MacAnalog/dn-005-pmu-ldo-capless-ihp130/doc/design-reference.md

# Design reference

KIND: REFERENCE (curated semantic facts; the pack carries the constraints section in full)

## Topology of record — `ldo_ihp_capless`

A **double-mirror flipped-voltage-follower (FVF)** output stage under a slow, high-gain outer
loop, in `sg13_lv_*` at 1.5 V. Chosen in experiment 002, sized in 003, drawn in 005.

**Read the schematic of record beside this section**, five blocks on one top sheet:
[`experiments/004-schematic/figs/ldo_ihp_capless.png`](../experiments/004-schematic/figs/ldo_ihp_capless.png),
regenerated by `experiments/004-schematic/build_sch.py` from the certified netlist and proven
equal to it device by device and parameter by parameter. The flat control sheet is
`ldo_ihp_capless_flat.png` beside it; the per-block sheets are `blocks_*.png`.

- **Output stage.** Pass PMOS `XMP` (19 fingers x 10 um, L 0.13 um). Control PMOS `XMC` whose
  source IS `vout` — the fast local loop. `XMC`'s drain current is folded to the pass gate as a
  **pull-up** through an NMOS 1:1 mirror (`XMA`/`XMB`) and then a PMOS 1:1 mirror (`XMCP`/`XMD`);
  the constant sink `XMS` pulls the gate down. The fold is what lets the gate reach `vdd - Vsd,sat`
  so the pass device turns fully **off** at hot/fast corners — a plain FVF caps the gate at `vout`
  and leaks 80-470 uA there (`journal/plain-fvf-gate-ceiling.md`). Each mirror node is a diode,
  i.e. low impedance, so the fold adds no high-impedance pole where a source-follower buffer did.
- **Outer loop.** Two-stage error amplifier: PMOS-input 5T OTA (`XMT`/`XM1`/`XM2`/`XM3`/`XM4`)
  then an NMOS common source under a PMOS current source (`XM5`/`XM6`), Miller cap `XCC` across
  stage 2 (dominant pole at `ea_o1`). It sets DC accuracy, PSRR and load/line regulation; the FVF
  sets the transient.
- **Feedback.** 1:1 `rhigh` divider `XR1`/`XR2` (340 um each) sensed through the 0 V loop-break
  marker `VLP`, with a 0.1 pF MIM `XCFF` across the top resistor cancelling the divider-node pole
  the resistors' own substrate capacitance makes.
- **Bias.** Resistor-referenced: `XRB` + NMOS diode `XMB0`, mirrored to the sink and, via the PMOS
  diode `XMBP`, to the error-amp tail. No ideal current sources. **This is the design's binding
  limitation** — see the constraint list below.
- **Output capacitor.** `XCOUT`, 4 x 5 pF MIM units on chip (21 pF total incl. the bench's 1 pF),
  well under the 100 pF bound: 002 showed the transient is loop-speed-limited, not charge-limited.

**Instance names above are role names; the certified netlist emits them segmented.** Since the
2026-09-05 recertification onto the drawn device set, `circuits/ldo_ihp_capless/pdk/ihp-sg13g2/netlist.spice`
carries `XR1_1..8`, `XR2_1..8`, `XRB_1..5`, `XMB0A`/`XMB0B`, `XM1A`/`XM1B`, `XM2A`/`XM2B`,
`XM3A`/`XM3B`, `XM4A`/`XM4B` and `XMSA`/`XMSB` — a grep for the bare `XR1` or `XMS` finds nothing.
`XMP` renders as `x_dut_xmp_m * x_dut_xmp_nf_mult` fingers of `x_dut_xmp_w / x_dut_xmp_nf_mult`.

**Where each artefact lives:**

| artefact | path |
|---|---|
| the design of record (sizing knobs and their defaults; a bare `ldo.dut.CANDIDATE` renders it) | `circuits/ldo_ihp_capless/pdk/ihp-sg13g2/sizing.yaml` |
| certified decks, sha-locked | `signoff/prelayout/decks/` with `SHA256SUMS` |
| schematic of record | `experiments/004-schematic/` |
| layout generator | `layout/gen_ldo.py` |

## Device map — the reference

The reference `ldo_005_buffered_ref` (analog-db, IHP binding). All MOS are `sg13_hv_*`
(3.3 V family).

| role | instances | what it does |
|---|---|---|
| reference buffer | `XMRA_*`, Miller `RRAZ`/`CRAC` | gains an ideal 0.8 V `VREF` up through `R1`/`R2` to 1.6 V |
| reference filter | `R_LPF`/`C_LPF` | RC filter on the buffered reference |
| error amplifier | `XMEA_*`, Miller `REAZ`/`CEAC` | drives the PMOS pass device |
| pass device | `XMP` (w×m) | PMOS |
| output bleeder | `R3` | bleeds the output |
| output capacitor | `C1` | on-die 10 pF |
| loop-break marker | `VLP lp_brk vout` (0 V) | what the `ac_loopgain` bench turns into a generator |

Sizing knobs and their defaults: `circuits/ldo_005_buffered_ref/pdk/ihp-sg13g2/sizing.yaml`; an
`ldo.dut.Design` is that circuit id + a dict of knob overrides.

## Validated model

**Loop-gain → load regulation.** ΔVout ≈ ΔIload·Rout_ol/(1+T0). The record measures
loop gain 49.95 dB (T0 = 314) and load regulation 0.028 mV over 0.1 → 10 mA, i.e. an effective
closed-loop output resistance of 2.8 mΩ and Rout_ol ≈ 0.88 Ω — the pass device's own 1/gm at
10 mA, as the relation predicts. The relation also holds across the corner table: load regulation
tracks 1/(1+T0) (0.017 mV at loop gain 52.6 dB, 0.056 mV at 45.9 dB).

**Pass-gate capacitance → undershoot.** From `journal/fvf-gate-cap-is-slew.md`, the pull-down
slew is I_B/C_gate. The layout adds 28.4 fF to a ~1 pF gate (+3 %) and S7 moves 104.8 → 113.9 mV
(+8.7 %) with recovery 0.125 → 0.150 µs (experiment 005 §1) — the predicted direction, and the
right order of magnitude given the FVF is pull-down-slew-limited on the falling edge only.

## Facts that constrain every candidate

1. **Cout is on chip: ≤ 100 pF total at the output node.** The reference's benches hang a 1 µF
   external capacitor on `vout`; a candidate may not. This moves the dominant pole inside the
   loop and is the whole difficulty of the capless class (provenance: `harness.yaml` goal;
   the reference's `analyses/*.yaml` bind `COUT: 1u`).
2. **Thin-oxide devices at 1.5 V.** `sg13_lv_*` are the 1.5 V family in the PDK registry
   (`_shared/pdk/ihp-sg13g2.yaml: supply.default: 1.5`); the reference is hv at 3.3 V, so
   none of its sizing carries over, only its structure and its benches.
3. **Quiescent current ≤ 50 µA is measured at no load** (`dc_op`, `i_supply`) — a bleeder or a
   minimum-load device counts against it.
4. **The bias binds at both ends, and S7 against bias current is a THRESHOLD, not a ramp.**
   *Every number in this item — the 25.6/61.9 µA spread, the `r_bias_l` sweep, the 41–50 µA window
   — was measured at the **36.28 µA** sizing point and has not been re-derived on the re-certified
   33.81 µA cell. The corner grid itself was re-run there (`experiments/007-post-layout-corners/`),
   and it no longer supports the "one mechanism, both ends" reading for S7 post-layout; the
   constraint the bias still owns at this sizing point is S5 at ff/125 °C.*
   The resistor-referenced bias makes every branch current scale with `rhigh`'s sheet resistance:
   Iq runs 25.6 µA at ss/−40 °C to 61.9 µA at ff/125 °C, a 2.4× spread on a 36.3 µA nominal. The
   resistor corner alone reproduces **both** failures; neither the transistor nor the capacitor
   corner reproduces either.

   **The S7 failure is a step.** Sweeping the bias resistor at ss/−40 °C:

   | Iq at ss / −40 °C (µA) | 30.9 | 28.8 | 27.8 |
   |---|---|---|---|
   | S7 (mV) | 83.8 | 88.3 | **309.8** |

   That is 3.5× of undershoot for a 3.4 % change of current, and the recovery time steps with it:
   0.14–0.20 µs below the threshold against 1.27–1.33 µs above it. It is a change of mechanism —
   the gate sink stops being able to slew the pass gate within the load step — not a degradation
   of one, and it is the same signature as the `c_ff_w` cliff. The same threshold exists at
   tt/27 °C between 30.7 and 25.9 µA.

   *FIGURE MISSING — S7 against bias-branch current at ss/−40 °C and ff/125 °C on one axis, with
   the 150 mV bound drawn and the 41–50 µA window shaded. The points exist only as review prose:
   `doc/reviews/review-002-capless-ldo.md` §3.4 carries 5 at ss/−40 °C and 7 at ff/125 °C, and M6
   in §2 carries the tt/27 °C pair (118.8 mV at 30.7 µA, 200.8 mV at 25.9 µA); M6's reproduction
   cell counts 18 points across three corners, 14 of them printed. `experiments/003-sizing/figs.py`
   is where the figure belongs, beside the same shape it already draws for `c_ff_w`
   (`cff_cliff.png`) — but the `r_bias_l` sweep must first be re-run into
   `experiments/003-sizing/out/` by a committed script: typing the review's numbers into
   `figs.py` would repeat the defect `cff_cliff.png` already has.*

   **Total Iq is a misleading proxy for it.** Slow transistors at −40 °C *lower* Iq by 15 % and
   *improve* S7 from 105 to 84 mV; it is the bias-branch current, not the total, that sets S7.

   **What the exit path actually costs.** A supply-independent bias does not relax both ends at
   once: pinned at the design's own 36.3 µA it still fails S7 at ff/125 °C (**165 mV**).

   | quantity | value |
   |---|---|
   | window that clears both corners | **Iq ≈ 41–50 µA** |
   | rise the 36.28 µA headline would have to take | 13–38 %, spending most of its S5 margin |

   A constant-*gm* / beta-multiplier reference is the wrong prescription in kind: it holds
   transconductance constant, while the quantity that sets the pass-gate slew is a current, and a
   beta-multiplier current still tracks the resistor and the mobility. **The corner-robust
   headline is therefore 41–50 µA, not 36.28 µA.**
   Provenance: `experiments/003-sizing/README.md` §3, `journal/resistor-bias-spread-binds-both-ends.md`,
   `doc/reviews/review-002-capless-ldo.md` §3.4 + M6 (18 bias points across three corners).
5. **Phase margin is measured with the true loop bench** (`ac_loopgain`, Middlebrook injection
   at `Vlp`), not the Zout-peaking proxy: the proxy read 0 dB on a revision of the reference
   that had no loop gain at all (analog-db `datasheet.yaml`, `pm_loop_deg` note).
