MacAnalog/dn-005-pmu-ldo-capless-ihp130/layout/ldo_ihp_capless/REVIEW.md

# Layout review — `ldo_ihp_capless` (IHP SG13G2), **round 4 re-review**, verdict **PASS with majors**

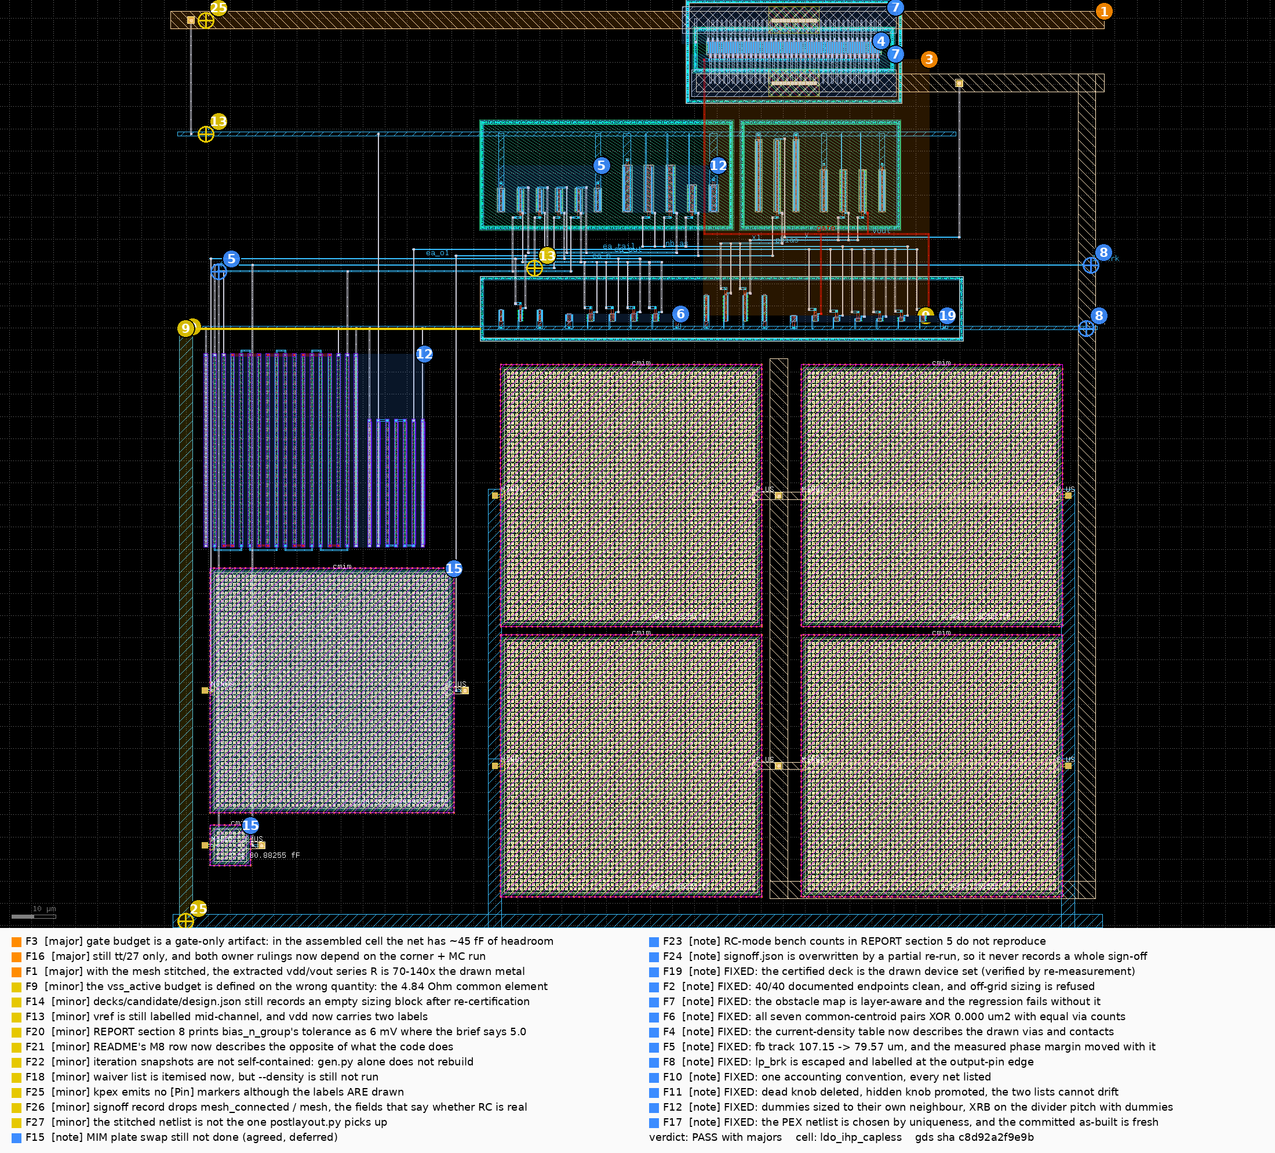
[picture p1: layout/ldo_ihp_capless/REVIEW.png]
annotated review


**KIND: REVIEW.** Independent gate on the fix round (`7ccc7b1`, layout of record **it12**), on top
of the re-certified deck (`bf3a4f8`) and the re-derived brief (`223373e`). Everything below is a
number this reviewer produced by rebuilding the GDS from the committed `layout/gen_ldo.py` and
re-running the tools; the designer's numbers are treated as claims throughout. Supersedes
`review-003` (FAIL, 3 blockers), whose nineteen findings are each given a verdict **by
measurement** at the end of the table.

**Verdict: PASS with majors.** The drawing reproduces completely — same GDS bytes, DRC 0, LVS
matched at both sizing points, 40/40 knob endpoints, current density 30/30, and all eighteen
post-layout metrics identical to the committed scorecard. **All three review-003 blockers are
closed**: the certified deck is now the drawn device set (F19, verified by re-measurement), the
knob ranges are walked and gated (F2, 40/40), and the undershoot credit is no longer banked (F3).
Three majors stay open, and none of them breaks a spec at tt/27:

1. **The `gate` budget is a gate-only artifact.** Everything the report measures reproduces, but
   nobody measured the net's headroom in the assembled cell. Swept in situ it is **~45 fF at
   0.44 mV/fF with no step** — the drawn 34.45 fF sits at about 43 % of what the net can carry.
   Owner ruling 1 asks for a topology decision on a number the assembled cell contradicts (F3).
   Demoted since the first draft of this review: **F9**, the `vss` active return. The report's
   14.3 Ω is wrong (mine: 20.88 Ω, 1.27× the brief's per-device budget), but I then put the solved
   return in circuit and the entire drawn per-device spread is worth **+0.04 dB** of PSRR. What the
   metric follows is the 4.84 Ω common element (−2.82 dB), which is 0.29× of budget. F9 is now a
   **minor**: a budget defined on the wrong quantity, and two wrong numbers in REPORT §6.4/§10.4.
2. **Still tt / 27 °C only**, and both owner rulings now depend on the corner + Monte-Carlo run
   that has never been done. The brief itself prices `ea_nmos_load` at 0.61 σ, which is **11 % of
   dies** on the dangerous sign of one class alone (F16).
3. **The RC extraction's mesh is now joined but its values are not usable.** On the fixed platform
   the port-to-device resistance of `vdd` is **49 Ω** where the drawn metal is 0.59 Ω, and nine of
   thirteen benches time out. The series-R numbers of record stay hand models — correct ones (F1).

## Findings

| # | severity | where (net / device / rule) | evidence | effect | fix → generator parameter | expected |
|---|---|---|---|---|---|---|
| **F3** | major | `gate`; pass array (47.57, 61.77)–(87.25, 64.89); Metal3 gate track (46.94, 3.01)–(98.09, 60.77) | Every reported number reproduces: `gate` 44.50 fF total / **34.45 to-rail** / 8.911 to `vout`; gate-only S7 **201.744 mV** (report 201.72); I built and extracted at `x_dut_xmp_nf_mult` = 2, 4, 8 and got to-rail **26.63 / 34.45 / 50.03 fF** — 3.91 and 3.895 fF per unit, intercept **18.81 fF** (report 3.9, ~18.8), and nf = 2 fails current density at **1.4626×** (report 1.46×). What nobody measured is the headroom **in the assembled cell**: sweeping a lumped `gate`→`vss` capacitor on the full 186-card extraction through the frozen `tran_load_step` gives S7 = 127.560 / 129.673 / 132.100 / 137.404 / 147.293 / 167.900 mV at +0 / 5 / 10 / 20 / 40 / 80 fF — **0.44 mV/fF, smooth, no step**, crossing 150 mV at **≈ +45 fF**. The brief's "step between 12 and 13 fF" is measured with every other parasitic zeroed; the assembled cell does not have it. | `v_undershoot_mv`: 22.4 mV of measured margin, and ~45 fF (130 % of the drawn value) of headroom on the very net the budget calls 2.87× over (what-if) | **new feature — a measurement, not a fix.** Run the full-PEX corner + MC sweep before an owner is asked to change the pass device, change the output stage, add a certified `ea_o1` capacitor or widen S7. A gate-only budget cannot answer whether 22.4 mV survives ss/−40. | ruling 1 either dissolves or acquires a number; today it has neither |
| **F16** | major | whole cell | Unchanged and now load-bearing. Both scorecards are tt / 27 °C. Three things make this the decisive gap: F3's margin is a cancellation whose corner behaviour is unmeasured; `brief.json` prices `ea_nmos_load` at 1.0 mV tolerated against a PDK 1 σ of **1.6468 mV** with `out_of_box` at 2.0 mV — I re-derived that σ myself, √2·A_VT/√(W·L) with A_VT = 2.0 mV·µm and W·L = 2.95 × 1.0 µm on the **whole** device, = 1.6468 ✓ — so **P(ΔVT > 2 mV on the dangerous XM3 side) = 11 %** of dies from one class alone, and `bias_p_group` is 9 %; and the re-certification moved Iq to 33.81 µA, toward the S7-vs-bias step review-002 M6 put near 30.7 µA. | not quantified — that is the finding | **new feature** — post-layout corner sweep on the extracted subckt plus a mismatch Monte Carlo on the drawn device set. | the input both open rulings are missing |
| **F1** | major | `vdd` strap (−73.5, 67.55)–(137.64, 71.55); `vout` riser (61.69, 52.33)–(73.13, 58.33); pass array; pins (−65.5, 69.55) and (133.64, 0.0) | Re-extracted on the fixed platform (`@b61f6c7`, `stitch_mesh=True`): **`mesh_connected=True`, 220 of 243 device pins on the mesh, 0 open nets**, 19 stub nets (the 18 divider nets + `lp_brk`, the rhigh terminal-region limit). The topology defect is fixed. The **values** are not usable here: solving the extractor's own network, R(`vdd` port → each of the 39 pass source columns) = **49.14–49.19 Ω**, identical for every column, i.e. a **~41 Ω common series element** on a path whose drawn TopMetal1 I solve at **0.59 Ω** and whose Metal2 comb at 0.017 Ω; R(pass drains → `vout` port) = **77.6 Ω** against 0.51 Ω drawn; column-to-column ≈ 16 Ω of terminal region in series with each 2.5 µm finger. The riser is 48 cuts per level plus 12 TopVia1, so 41 Ω implies ≈ 2 kΩ per cut — a figure **inferred from the arithmetic**, not read out of kpex. The benches agree: **9 of 13 fail** (was: singular matrix), and the log names the mode — ngspice drops from KLU to SPARSE 1.3, coerces all 33 `Rstitch_` to 1e-12 Ω, then `Dynamic gmin stepping failed` / `True gmin stepping failed` / `source stepping failed` / `Transient op started`: **the DC operating point does not converge**, and the transient-op fallback runs out the 600 s budget and the four that finish give psrr_1k **−5.549 dB** against 70.09. The one credible net is `vss`, because that path is Metal1 end to end — and there the mesh (4.11 Ω aggregate, 10.5–24.0 Ω per device) matches my drawn-metal solve (4.84, 12.5–20.9) to ~15 %, which is what makes F9 a two-method result. | `v_dropout_mv` **+10.8 mV**, 45 % of the brief's 23.83 mV pool (hand model, now *solved* on the drawn metal: 10.34 × 0.5895 + 8.64 × 0.5446; report 10.98 mV / 46 %) | **new feature, upstream.** Report the residual kpex defect with these numbers — it is terminal/via resistance, a different defect from the island just fixed. Add a sanity gate beside `mesh_connected` (port-to-pin R orders of magnitude above the drawn metal's bound ⇒ refuse). And see F27: the stitched file is not the one consumers glob. | RC becomes a measurement when the terminal values are fixed; until then the hand model stands |
| **F9** | minor | `vss` riser (−71.5, −135.5)–(−68.5, 0.3); bare rail run (−70.0, 0.0)→(−3.4, 0.0); `XMSb` (95.72, 1.42)–(97.35, 2.88) | **(a) The report's number is wrong.** §6.4 models the worst active device at **14.3 Ω** of a 16.4772 Ω budget ("89 % spent"). Solved instead of modelled — Metal1 rasterized at 0.1 µm, component flood-filled from the `vss` pin, Laplace at 110 mΩ/sq (validated on an analytic bar to −0.1 %): common series element **4.84 Ω** (report 4.91 ✓), worst device `XMS`b **20.88 Ω** = **1.27×** budget. Mechanism: from the riser top the return runs **66.6 µm of bare 0.8 µm rail** (9.44 Ω) before the row-A ptap ring begins — that ring spans only x = −3.4 to 105.58, and §6.4 credits it over the whole 170 µm. 14.3 Ω is my solve for a device at **x = 0**, the near end. §10.4's "`rail_w` 1.2 → ~12.7 Ω" has the same error; interpolating my two solved builds gives ~16.6 Ω, on the budget line. **(b) But that is not the quantity the metric follows.** Put in circuit through the frozen benches (every vss-connected element behind the common element, each active group behind its own extra hop, XCOUT on its own strap — the generator's split): common 4.84 Ω alone → psrr_1k **67.277 dB**; adding the full drawn 14.4–20.9 Ω spread → **67.316 dB**. The whole distributed per-device return is worth **+0.04 dB**. As a lumped element the drawn cell is ~4.9 Ω = **0.30× of budget**. Controls confirm the report's own partition: active devices alone behind 32 Ω move psrr_1k **+0.099 dB** and S7 +0.11 mV; XCOUT alone behind 32 Ω improves S7 to 114.0 mV. | `psrr_1k_db` **−2.82 dB** (what-if) — and this is the real content: the committed 70.093 dB is measured with the ground return **ideal** (CC carries no vss resistor; XCOUT is re-attached by name to the pin), so 2.82 dB of the reported figure is a modelling choice, 2.78 dB of it the common element. S6 is ≥ 40 dB, so 67.3 dB is not a spec risk. Caveat: this moves `VREF`'s return onto the internal ground with everything else — the frozen bench's own convention (VREF lives inside the DUT block), and the reason my −0.372 dB/Ω reproduces the brief's −0.4553, so it is the right model for checking the brief. | **Correct the brief, not the drawing.** Budget `vss_active` on the **common series element** (4.84 Ω drawn, 0.29×) and drop the "worst active device" row — I measured it at +0.04 dB. Correct §6.4 (14.3 → 20.88 Ω at the far end) and §10.4 (1.2 → ~16.6 Ω). Only if the corrected budget ever binds: `rail_w` = 1.4 is measured (bounds build, DRC 0, LVS matched, CD 0.836×) at 15.13 Ω worst / 4.84 Ω common, worth **+1.15 dB** in circuit; `vss_ret_w` = 6.0 takes the common element to 2.43 Ω and is the better lever for the quantity that matters. | no metric moves > ~1 dB of a 27 dB margin; the deliverable is a corrected budget row and two corrected REPORT numbers |
| **F25** | minor | pins (−65.5, 69.55), (133.64, 0.0), (−70.0, −134.0) | The kpex report database has **594 `[Device Terminal]` markers and zero `[Pin]` markers**, although the GDS carries 17 text labels **and those labels do reach kpex** — its raw netlist header is `.SUBCKT ldo_ihp_capless vss fb lp_brk ea_o1 ea_out nbias x1 y gate ea_n vdd ea_tail vref pbias vout`, 15 ports derived from them. So "the generator draws no pin labels" is not the mechanism; whatever makes a `[Pin]` marker, a text label on the routing layer is not it. So the stitcher has no port anchor and ties each flat net at a node it picks — `vdd.P0.25`, `vout.P0.25`, `vss.P0.24`: polygon 0 of a layer, not the pin. Every port-referred series-R number is therefore referred to an arbitrary point in the net. `vss` came out right only because its tie landed near the pin. | no electrical effect; it is why F1's numbers cannot be compared to a pin-referred budget | **Do not redraw anything yet.** A pin-datatype polygon per port (`vdd`/`vout` 126/2 + 126/25 at the strap ends, `vss` 8/2 + 8/25 at the riser foot, `vref`/`fb`/`lp_brk` likewise) is a **hypothesis** about what kpex 0.3.12 wants, not a diagnosis. Ask the platform which geometry produces a `[Pin]` marker — on the 5-T OTA example where the stitch was verified — then draw that. Same change F13 asks for from the other side. | the brief's series-R rows become directly checkable against the extractor |
| **F26** | minor | `layout/signoff.py` `pex()`, ~line 275 | `pex()` returns `{ok, available, mode, netlist, n_c, n_r, per_net_c_ff, reason, log_tail}` and drops `PexResult.mesh_connected` and `.mesh` — the two fields that separate "RC ran" from "RC measured something". On this cell they carry the real state: 220/243 pins, 0 open nets, **19 stub nets**, so any `fb`/`lp_brk` series-R statement from an RC run is empty. The stage prints `PEX: ok=True n_C=186 n_R=8566` and the JSON keeps no more. The docstring above the call is also stale — it explains a cwd dance to contain `<cell>_extracted.cir`, which the platform fixed at `97cc0be`. | no electrical effect; the record cannot distinguish a measured RC row from an empty one | **`layout/signoff.py`**: add `mesh_connected` and `mesh` to the dict, and gate on them the way DRC and LVS are gated now. | the round's JSON says how much of the mesh was connected |
| **F27** | minor | `layout/postlayout.py` `main()` | The platform writes `..._k25d_pex_netlist.spice` (raw) **and** `..._k25d_pex_netlist_stitched.spice`, and `PexResult.netlist_path` names the stitched one. `postlayout.py` selects with `rglob("*_pex_netlist.spice")` and demands exactly one match — the stitched name does not match that glob, so it finds exactly one file, reports no ambiguity, and measures the **raw** netlist. I had to symlink the stitched file under the expected name to run the benches on it. This is F17 in a new form, and worse: it fails silently and confidently. | an RC scorecard from this path would be the unstitched netlist, i.e. the artifact F1 says measures nothing (what-if) | **`layout/postlayout.py`**: take the path from the PEX stage's record (`signoff.json` already has `pex.netlist`), or prefer `*_stitched.spice`. | the file the extractor named is the file the benches measure |
| **F14** | minor | `decks/candidate/design.json` | Still `"sizing": {}`. The deck set was re-issued wholesale at `bf3a4f8` — all 13 `.spice`, `SHA256SUMS`, `decks.sha256`, `scorecard.json` — and the file named as the sizing of record is still empty, across a certification boundary that introduced a new knob (`x_dut_xmp_nf_mult`). | provenance only | write the resolved knobs at freeze time, or drop the key rather than carry it empty | the certified deck names its own sizing point |
| **F13** | minor | labels at (8.81, 13.53), (−62.6, 12.83), (−65.5, 43.83), (−65.5, 69.55) | PLAN A1 still says `vref` + `fb` on the **left** edge. `fb` moved and is at (−62.600, 12.830) — fixed. `vref` is at (8.810, 13.530), 71 µm inside the cell. New: `vdd` now carries **two** labels, Metal1 (8/25) at (−65.500, 43.830) and TopMetal1 (126/25) at (−65.500, 69.550) — the same ambiguity F9 raised for `vss`, now resolved there (exactly one `vss` label) and reintroduced here. | interface clarity; F25 shows why the pin location is not cosmetic | `gen_ldo` label placement — `vref` on the left edge, one `vdd` label — or amend A1 | one label per pin, on the declared edge |
| **F20** | minor | `bias_n_group` (66.54, 1.42)–(102.18, 2.88) | REPORT §8's columns are `tolerated \| 1 σ \| headroom`, and the `bias_n_group` row reads `6 mV dVT (step) \| 2.43 mV \| 2.06`. 6 / 2.43 = **2.47**, not 2.06. `brief.json` gives that class `tolerated.dvt_mv = 5.0`, `sigma 2.4318`, `headroom 2.056`, and BRIEF.md line 49 says "5 mV, 2.06 σ, step at 6 mV" — the printed value is the **step** in a column headed *tolerated*. Every other row closes (1.0/1.6468 = 0.607, 1.2/1.118 = 1.073, 2.9477/1.6197 = 1.820, 0.989/0.575 = 1.72, 20.78/1.6648 = 12.48, 40.59/1.6623 = 24.42). | none; the one row a reader would check is the one that does not close | generate §8 from `brief.json` (as the Iterations table is generated from `iterations.yaml`) with separate *tolerated* and *step* columns | every row's headroom = tolerated / 1 σ |
| **F21** | minor | `README.md` line 69 (M8 row) | Four claims, all now false: "**no case that fails without it**", "the power combs are **routed around** on Metal3 (`to_track_m3`) rather than claimed", "five cases", and a pointer to "REPORT §10.5" for an `xmp_nf_mult = 1` short. `claim_box` records the comb, `to_track_m3` is gone, `test_builder.py` has nine cases, REPORT §10 has no item 5, and `xmp_nf_mult` is no longer a layout knob. I ran the missing test: copy `router.py`, make `claim_box` a no-op, run the suite → **4 failures**, exit 1, including `test_without_the_claim_the_allocator_walks_into_the_comb: alloc returned 44.1, inside the comb`. | the row understates the repo | rewrite the M8 row; drop the dangling §10.5 reference | the closed-findings table matches the code |
| **F22** | minor | `iterations/it*/gen.py` | `it11/gen.py` is a full generator copy but lines 60–61 are `import netlist_ref as NR` and `from router import ObstacleMap`, resolved from the caller's path. Run as the trail implies it fails with `ModuleNotFoundError: No module named 'netlist_ref'`; it only builds with today's `layout/` on `PYTHONPATH`, i.e. against today's `router.py` — the file that changed in exactly the rounds the trail records. Harmless this time (it rebuilds byte-identical to `a66d15b5…`, which is how I verified the trail) but a snapshot that needs files outside itself is not a snapshot. | the trail's reproducibility is conditional on files it does not carry | `signoff.py _snapshot`: copy `netlist_ref.py` and `router.py` beside `gen.py` and record their shas | `python it<N>/gen.py` reproduces `gds_sha256` with nothing else on the path |
| **F18** | minor | whole cell | Half fixed: §3 now names all twelve waived rules, which is what the finding asked. But the run is still `--no_density`, so whether the waived set grew with a 4.8 %-larger floorplan and two new wide straps is unverified. My own DRC was `--no_density` too — I did not close this either. | DRC 0 is conditional on a rule set neither of us ran | run `--density` once and diff against the twelve | the waived set is measured, not assumed |
| **F15** | note | XCFF (−64.6, −121.5)–(−55.4, −112.3); XCC (−64.6, −109.5)–(−9.4, −54.3) | Accepted and deferred (§8.2 dev. 2, §10.9), worth ≈ +0.3° for a certified-netlist edit and a re-freeze. I agree with the disposition. `bf3a4f8` was the cheap moment — the netlist was being re-issued and re-frozen anyway — and it was not taken. | `pm_loop_deg` +0.3° (hand) | fold into the next re-freeze | a few fF off `fb` at zero simulated cost |
| **F23** | note | REPORT §5 | §5 states "RC: 8/13 ran, 7 violations" and that "the transient benches that do run reproduce the CC row exactly". On the same platform I get **4/13 ran, 4 violations**, with both transients — the two named — aborting, and the DC rows returning i_q 40.67 µA against 33.81 and line_reg 8.502 mV against 0.056. R counts differ too (8545 `Rext_` vs 8548). The conclusion is unaffected and independently proved by the node sets; the counts are artefacts of an ill-conditioned matrix and should not be quoted as measurements. | none | state the node-set test, drop the bench counts | one deterministic statement instead of two run-dependent ones |
| **F24** | note | `layout/signoff.py` `main()` | `rec` is built from this invocation's stages and written whole, so the documented two-step PEX flow leaves `signoff.json` containing only `{"pex": {...RC...}}`. I hit it: after my RC pass the file had lost the build, current-density, DRC and LVS verdicts I had just produced. They survive only in the console log, which is not the artifact. | none | merge into an existing `signoff.json`, or write one file per invocation | one file carries every stage of the round |
| **F19** | note ✅ **fixed** | `bias_n_group`; pass array | Ruling adopted (PLAN §0.1, `bf3a4f8`). In the file: the certified netlist carries `XMB0A/B`, `XMB1A/B`, `XMSA/B`, `XM1A/B`…`XM4A/B` as half-width cards, `XR1_1..8`, `XR2_1..8`, `XRB_1..5` as segment strings, and `XMP … w={x_dut_xmp_w/x_dut_xmp_nf_mult} m={x_dut_xmp_m*x_dut_xmp_nf_mult}`. By measurement: my extraction with all 186 `Cext_` deleted returns i_q **33.80539**, v_out **1.199499**, undershoot 115.065, pm 72.5064, dropout 104.671 — `decks/candidate/scorecard.json` to the resolution of every bench. | — | — | closed |
| **F2** | note ✅ **fixed** | `LayoutParams.BOUNDS` | I re-ran the new `bounds` stage: **40/40 built, DRC 0, LVS matched, current density pass**, worst 0.9835×. DRC and LVS are gates now (a non-matching build writes no scorecard). `tap_pitch` deleted, `isl_gap`/`gpad`/`vss_ret_w` promoted, and an assert forces `set(BOUNDS) == LayoutParams` fields. The `xmp_nf_mult` half moved to `sizing.yaml` and is handled there: building at the off-grid `= 3` now raises *"XMP: unit finger 3.33333 um is not a multiple of 0.01 um"* instead of silently drawing a 189.81 µm device. Residue, not a finding: nothing walks the **sizing** space, and `= 8` is legal (DRC 0, LVS matched, CD 0.836× in my own build) at 50.03 fF of `gate` — see F3 for why that is now a smaller worry. | — | — | closed |
| **F7** | note ✅ **fixed** | Metal2 combs (42.18, 64.33)–(90.54, 72.55) and (44.28, 52.33)–(90.54, 61.93) | `claim_box` records any drawn rectangle on a named layer and `column_free` compares per layer, so the combs are obstacles to Metal2 and invisible to Metal3 — which let the hard-coded `to_track_m3` go. I ran the "fails without it" test: `claim_box` as a no-op fails **4 of 9** cases, exit 1, including `test_without_the_claim_the_allocator_walks_into_the_comb`. And the class is gone: `col_vias` 3 and 4, which extracted `gate\|vout` before, both LVS-match in the walk. | — | — | closed |
| **F6** | note ✅ **fixed** | `ea_in_pair` (0.29, 26.16)–(23.99, 36.78); `ea_nmos_load` (15.74, 1.42)–(41.82, 3.255) | My own test on this drawing: at device bbox + 1.2 µm all **seven** pairs read **0.000 µm²** with equal Via1 counts (3v3, 3v3, 1v1, 1v1, 1v1, 2v2, 1v1) — better than the report's 0.000–0.011. At my wider +2.4 µm window the two row-A groups stay 0.000 while `ea_in_pair` reads 42.2 % / 12.3 %; since +1.2 is exactly zero, all of it lies in the 1.2–2.4 µm annulus, i.e. the neighbourhood, as the report says. `ea_in_pair` now sits at the row end (F5) so its halves see different outer neighbours — a second-order LOD term at 1.82 σ; the 0.61 σ class is symmetric at both windows. | — | — | closed |
| **F4** | note ✅ **fixed** | pass array (47.57, 61.77)–(87.25, 64.89) | `power_path.json` declares `n_vias = 2` on the S/D column Via1 and `7` on the diffusion contacts, over 30 segments. Counted from my rebuilt GDS: source side 40 Via1 columns / 79 cuts, drain side 39 / 77 — 2 per column except the single leftmost end column each side (x = 45.18, 47.13), which serves one finger. Contact histogram is dominated by 73 columns of 7. Both declared numbers are the drawn ones, and the table now also carries the rails and both `vss` returns. CD 30/30, worst 0.836×, reproduced. | — | — | closed |
| **F5** | note ✅ **fixed** | `ea_in_pair` moved to the head of row B; `fb` label (−62.6, 12.83) | Device boxes now at x = 4.67 / 9.05 / 13.43 / 17.81 with `bias_p_group` to their right. Measured in my extraction: `fb` 33.97 → **31.90 fF total / 21.20 to-rail**, **0.78×** of the 27.1 fF budget. Phase margin 68.76 → **69.301°** in the reproduced row. | `pm_loop_deg` +0.54° (what-if) | — | closed |
| **F8** | note ✅ **fixed** | `lp_brk` label (134.64, 14.23) beside the `vout` pin (133.64, 0.0) | The GDS now says where the divider senses: `lp_brk` escaped and labelled at the output-pin edge, recorded as an interface contract in PLAN A12, with the choice settled by measurement (sensing at the pass drain gives S2 = 10.22 mV against a 5 mV line). Cost reproduced: `lp_brk` 18.2 → 37.93 fF / 24.26 to-rail on a net with no budget. | — | — | closed |
| **F10** | note ✅ **fixed** | REPORT §7 | One stated convention (budgets are to-rail), every net listed, `x1` and `y` printed as values (11.38 / 6.91 and 11.62 / 8.34) instead of a bound, `fb` at 0.78×. Every entry reproduces to the digit against my own parse, including `Cext_127 fb↔lp_brk 4.2346 fF`. | — | — | closed |
| **F11** | note ✅ **fixed** | `LayoutParams` / `BOUNDS` | `tap_pitch` gone, `isl_gap` + `gpad` + `vss_ret_w` in both lists, and an import-time assert that the two sets are equal. 20 knobs; I walked all 40 endpoints. | — | — | closed |
| **F12** | note ✅ **fixed** | `bias_p_group` (28.57, 26.16)–(50.39, 36.78); resistor block (−66.0, −49.5)–(−16.1, −5.78) | Read from my rebuild: `bias_p_group` runs d(10.62) XMBP(10.62) XMT(10.62) XM6(6.15) d(6.15) — the right dummy matches its neighbour. The resistor block is one pitch throughout: divider 18 segments at 2.0 µm from −66 to −32 (16 members + a tied dummy each end) and `XRB` 7 segments at the **same** 2.0 µm from −29 to −17 (5 + a dummy each end), where it was 5 at 1.6 µm with none. | — | — | closed |
| **F17** | note ✅ **fixed** (see F27) | `layout/postlayout.py` | `hits[-1]` is replaced by "exactly one match, or list them with mtimes and stop", and the freshness half checks out by measurement: the committed `asbuilt/core_pex.sp` is byte-identical to my own extraction on all 186 `Cext_` cards. The file also grew `--keep-c` / `--drop-c` / `--no-c` and refuses to overwrite the record — which is how F3 and F19 above are reproducible by anyone. The *identity* half is re-opened as F27. | — | — | closed |

## Would a senior analog layout engineer accept this at a glance?

Graded on geometry read out of the GDS I rebuilt, not on impression.

| what a reviewer looks at | measured | verdict |
|---|---|---|
| matching sequence, `ea_in_pair` | generator declares XM1A·XM2A·XM2B·XM1B; the six slots at x = 0.29 … 22.19 are one pitch with a dummy each end, so the drawn sequence is d·**ABBA**·d with **both centroids at x = 12.14** | ✅ common centroid, which is what a *ratio*-setting pair needs |
| matching sequence, `ea_nmos_load` | declared XM3A·XM4A·XM4B·XM3B; six slots at x = 15.74 … 40.14, d·**ABBA**·d, **both centroids at x = 28.78** | ✅ |
| matching sequence, `bias_n_group` | declared XMSA·XMB1A·XMB0A·XMB0B·XMB1B·XMSB — and the drawn device heights read it back without trusting the source: 1.46 · **1.46 / 1.055 / 0.860 / 0.860 / 1.055 / 1.46** · 1.46 µm, mirror-symmetric, so d·**ABC·CBA**·d with **all three centroids at x = 84.36** | ✅ three-class common centroid, dummies both ends |
| matching sequence, `fvf_fold_n` / `fvf_fold_p` | four slots at x = 47.02 … 60.16: d·A·B·d, adjacent and same orientation, **not** a centroid — the generator's declared `same_row_same_orientation` | ✅ and it *exceeds* the brief, which asks only for `any` on `fvf_fold_n` (24.4 σ of headroom) and `same_row_same_orientation` on `fvf_fold_p` (12.5 σ) |
| technique used vs. technique the brief implies | brief: `common_centroid+dummies` on `ea_nmos_load`, `bias_p_group`, `ea_in_pair`, `bias_n_group`, the divider; `interdigitated+dummies` on the two MIM ratios; `same_row_same_orientation` / `any` on the folds. Drawn: centroid where a ratio is set, same-row for the 1:1 folds, one pitch + dummies on the divider — **every class matches or exceeds its declared pattern** | ✅ |
| dummy sizing, `bias_p_group` | d(10.62) · XMBP(10.62) · XMT(10.62) · XM6(6.15) · d(6.15) — read off the drawn heights; each end dummy is sized to **its own** neighbour, not to a common value | ✅ |
| pair geometry + neighbourhood | translation-XOR of all **seven** classes at device bbox + 1.2 µm = **0.000 µm²** each, with equal Via1 counts. This proves *geometry*, not sequence — at a ~4.85 µm pitch and a ~1.7 µm device the +1.2 µm window stops short of the neighbour, so the sequence rows above rest on the slot read, not on this | ✅ |
| do the tap rings **close**? | five well/substrate islands, each tap region merges to **one polygon with a hole** — a true ring, not contacts on a pitch: NWell islands (−3.71, 22.01)/(55.17, 22.01)/(44.57, 57.52) with 444 / 326 / 296 contacts and 0.98–0.99 bbox coverage, and two ptap rings (−3.40, −2.90) and (43.07, 50.83) | ✅ |
| resistors on one unit pitch | divider 18 segments at **2.0 µm** (16 members + a tied dummy each end); `XRB` 7 at the **same** 2.0 µm (5 + a dummy each end) | ✅ |
| capacitors on one pitch, dummy ring | XCOUT 2×2 on one pitch about a central top-plate spine, bottom plates on one side — but **no MIM dummy ring** | ⚠️ declared deviation (PLAN §6: a ring of 58 µm units would triple the block). Accepted, recorded |
| pin labels on the declared sides | `vss` ×1 ✅, `lp_brk` at the output edge ✅, `fb` on the left edge ✅ — but `vdd` carries **two** labels and `vref` sits **71 µm inside** the cell | ⚠️ F13 |
| strap width vs J_max | 30/30 current-density budgets, worst **0.836×**; over the 40-endpoint knob walk, worst 0.9835× | ✅ |
| **overall** | reads as a laid-out cell: framed rows, dummies sized to their neighbours, closed rings, one pitch per array, and common centroids that actually coincide to the nanometre | **ACCEPT**, with the two ⚠️ above |

## What reproduced

| | designer's claim | my measurement | |
|---|---|---|---|
| build | it12, area 44 266 µm² | GDS sha256 `c8d92a2f…` = `iterations.yaml` it12; area 44 266; bbox (−73.50, −135.50)–(137.64, 74.15) | **match** |
| trail | it11 → it12 moves 858.3 µm² on Metal1 | rebuilt `it11/gen.py` → `a66d15b5…` (its recorded sha); XOR against it12 = **858.26 µm² on layer 8/0 and zero on every other layer** | **match** |
| current density | 30/30, worst 0.836× | 30/30, worst 0.836×; `n_vias`/contacts verified against the drawn cuts (F4) | **match** |
| DRC | 0 | 0 (`--no_density`) | **match** |
| LVS | matched, against the re-certified netlist | matched; reference sha `f573b653…` from `netlist.spice` `f5c4efb0…`; card-by-card audit of the split | **match** |
| second sizing point | (PLAN gate 4) | 002 hand point (`76eddd6`, 13 knobs differ): build 41 055 µm², CD 0.836×, DRC 0, **LVS matched** | **match** |
| knob ranges | 40/40 endpoints clean | 40/40 built, DRC 0, LVS matched, CD pass; worst 0.9835× | **match** |
| PEX CC | 186 C / 21 R | 186 C / 21 R; every per-net number to the digit; `asbuilt/core_pex.sp` byte-identical | **match** |
| scorecard | 18/18, 0 violations | all 18 identical to the committed digits through the frozen path | **match** |
| F19 closure | certified deck = drawn devices | extraction with all 186 `Cext_` deleted = `decks/candidate/scorecard.json` at every bench's resolution | **match** |
| gate-only S7 | 201.72 mV | **201.744 mV** | match |
| `gate` vs `nf_mult` | 26.63 / 34.45 fF, 1.46× CD at nf = 2 | 26.63 / 34.45 / **50.03** at nf = 2 / 4 / 8; CD **1.4626×** at nf = 2; nf = 3 refused by an assert | match, extended |
| series R, TopMetal1 | 0.598 Ω (`vdd`), 0.556 Ω (`vout`) | Laplace on the drawn metal: **0.5895** and **0.5106** Ω; Metal2 combs add 0.017 / 0.034 Ω; pool 10.80 mV of 23.83 (45 %) vs the report's 10.98 / 46 % | **match** |
| series R, `vss` common | 4.91 Ω | **4.84 Ω** (drawn-metal solve), 4.11 Ω aggregate from the stitched mesh | match |
| series R, `vss` worst device | 14.3 Ω, "89 % of 16 Ω" | **20.88 Ω** drawn-metal, 10.5–24.0 Ω extracted — 1.27× the budget, but worth **+0.04 dB** in circuit | **DIFFERS — F9** |
| PSRR with the drawn ground return | not measured (return is ideal in both rows) | 70.093 → **67.316 dB** with the solved return in circuit; 67.277 dB from the common element alone | **new — F9** |
| RC benches | 8/13 ran, 7 violations | 4/13 ran, 4 violations (unstitched); **4/13 ran, 9 timeouts** (stitched) | **DIFFERS — F23, F1** |
| RC mesh | electrically absent | confirmed absent on the old platform; on `@b61f6c7` `mesh_connected=True`, 220/243 pins, 0 open nets, 19 stub nets — but 49 Ω port-to-device on `vdd` (F1) | fixed topology, unusable values |

## What I could not check

- **Corners and Monte Carlo** — still nothing outside tt / 27 °C, by either of us (F16). This is the
  largest open item in the cell, not a footnote.
- **DRC with `--density`** — not run by the designer and not by me (F18).
- **Wire resistance as an extracted quantity** — the mesh is joined now but its `vdd`/`vout` values
  are not credible (F1), so every series-R number here is a Laplace solve on the drawn metal at
  the PDK's own sheet resistances: an independent model, not an extraction.
- **The `vss` solve is Metal1-only.** I checked that net for Metal2 shunts and found none that
  matter (five 0.38 µm columns with one Via1 each and four 1.3 µm MIM-return pads). Substrate
  conduction is modelled by nobody.
- **MIM top-plate coupling and n-well-to-substrate junction capacitance** — in neither the
  extractor nor the model cards.
- **The sizing space is not walked.** I probed `x_dut_xmp_nf_mult` at 2, 3 and 8 only.
- **Mismatch Monte Carlo on the drawn cell** — not run. I checked the brief's σ arithmetic (right,
  and computed on the whole device) but did not simulate the distribution.
- **Iteration diffs** — I verified it11 → it12 by rebuilding and XORing. The other ten
  `diff_it*_it*.png` were not opened.
- **The report's "a Metal3-over-Metal2 shield costs only +3 fF on `gate`→`vout`" claim** — not
  rebuilt. ~51 µm² of added M3-over-M4 overlap at ~0.05 fF/µm² makes +3 fF plausible, and it is
  moot either way: F3 measures ~45 fF of in-situ headroom on that net.
- **Inductance, sealring, fill, ESD, antenna** — out of scope per PLAN §7.

## Verdict

**PASS with majors.** Nothing in the spec box is broken at tt / 27 °C, every gate reproduces, and
all three review-003 blockers are closed by measurement rather than by changelog. Three things
would go back to the designer and one to the platform:

1. **F3** — the `gate` budget is gate-only; swept in situ the net has ~45 fF of headroom at
   0.44 mV/fF with no step, so owner ruling 1 should ask for the corner run (**F16**), not for a
   topology change.
2. **F16** — the cell has never been measured outside tt / 27 °C, and the brief's own 0.61 σ on
   `ea_nmos_load` is 11 % of dies on the dangerous side. Both owner rulings depend on this run.
3. **F1** — the RC mesh is joined but reads 49 Ω where the drawn metal is 0.59 Ω, and nine of
   thirteen benches time out; the residual defect is terminal/via resistance and belongs upstream.

Every magnitude above is labelled `what-if` (measured on a modified netlist through the frozen
benches), `solve` (a Laplace or nodal solve on drawn geometry / extracted values) or `hand`
(arithmetic from PDK constants). F9 is the case for doing that: read as a hand model it was a
major, and one what-if through the frozen benches made it a minor. The `what-if` numbers are single-variable and can be A/B'd one at
a time.
