MacAnalog/dn-005-pmu-ldo-capless-ihp130/signoff/README.md

# Sign-off — the design of record

KIND: REFERENCE (what a reader is entitled to trust. `experiments/` is where these numbers came
from; this tree is what survived.)

**One rule decides whether a file belongs here: has it been measured, and does it say under what.**
An artefact reaches this tree when a bench produced it and someone wrote down the conditions.
Everything still being explored stays in `experiments/NNN-*/`.

## What is signed off

Fill one row per fidelity you have actually run. `status` is `certified` only when a signed ledger
row exists for it (`make certify ARGS="--author X --verified-by Y"`); anything else is `measured`,
`in progress` or `planned`.

| fidelity | what the number includes | scorecard | status | signed by | date |
|---|---|---|---|---|---|
| `prelayout` | schematic netlist; no interconnect parasitics | `prelayout/decks/scorecard.json` | certified | see its provenance block | 2026-09 |
| `postlayout-pex` | + R/C extracted from the layout of record | `postlayout-pex/decks/scorecard.json` | planned | — | — |
| `postlayout-em` | + EM-solved interconnect and passives | `postlayout-em/decks/scorecard.json` | planned | — | — |

A design that never draws a layout keeps only the first row and deletes the other two directories.

## The tree

| path | holds | written by |
|---|---|---|
| `schematic/` | the topology of record: the as-built subckt netlist, its xschem sheet, the sizing table | `schematic-of-record` skill |
| `layout/` | the layout of record: GDS, render, DRC and LVS reports | `layout/signoff.py` (the generator is code, and stays in `layout/`) |
| `<fidelity>/decks/` | the frozen bench decks, sha-locked by `make freeze` | `make certify` |
| `<fidelity>/decks/scorecard.json` | every spec key, its measured value and its verdict — written INSIDE the frozen dir, because that is where `--certify` writes it | `make certify` |
| `<fidelity>/figs/` | the figures that carry the claims, each regenerated by a committed script | `plot.py` / the fidelity's own script |
| `<fidelity>/tables/` | the same numbers as CSV, so a later run can diff them | `make certify`, experiment close-out |
| `<fidelity>/REPORT.md` | what was measured, under what conditions, and what it means | the person or agent closing that fidelity |

## Adding a fidelity

The three shipped directories are simulation fidelities of an electrical design. A design in
another physics domain adds its own directory beside them — TCAD drift-diffusion for a device
cross-section, 3-D FDTD for an optical structure — with the same contents (`decks/`, holding its
`scorecard.json`; `figs/`; `tables/`; `REPORT.md`) and a row in the table above.

**Two things make a new fidelity real rather than a folder:** a `REPORT.md` that states the solver
and its version, and a `scorecard.json` written by the same `metrics` code path as every other
fidelity. A number produced by a one-off script is a report, not a reference.

## What does NOT belong here

**A yardstick is not a sign-off.** A design often carries a second certified deck set — prior art,
a paper being replicated, the incumbent being beaten. It is frozen, it is sha-locked, it is
reproduced by `make check`, and it is still not this design's result. It stays in `decks/`.

The distinction is worth stating because the config key does not make it: `reference_scorecard`
means *the scorecard `make check` reproduces*, which a design may legitimately point at the
yardstick rather than at itself. So the key cannot tell you which directory is the design of
record — only the design's own docs can.

| directory | holds | goes in `signoff/`? |
|---|---|---|
| this design's certified benches | what this design achieved | **yes** — `signoff/<fidelity>/decks/` |
| the prior-art / replication baseline | what it is measured against | no — `decks/`, still frozen |

If both exist, say which is which in the table above, and give the yardstick a row in the design's
`doc/target-spec.md` instead.

## Wiring it to the harness

Three lines in `harness.yaml` point the machinery at this tree. Nothing else needs to change:

```yaml
frozen: [signoff/prelayout/decks]                       # sha-locked by `make freeze`
reference_scorecard: signoff/prelayout/decks/scorecard.json   # what `make check` reproduces
```

**A design that certified before 2.00 should NOT `git mv` its frozen directory here.** A certified
`scorecard.json` carries a provenance block naming its own artefacts by path, so moving the
directory invalidates the certification — `scorecard-recompute` goes red with *"raw
`<old-path>/decks.sha256` is missing"*, and regenerating it means a live re-certification and a
second actor's signature.

Point this tree at the directory instead: name it in the table above and in the fidelity's
`REPORT.md`. Move it physically the next time you re-certify anyway — the new provenance is then
written at the new path at no extra cost. **A sign-off tree that says where the design of record
lives is worth more than one that holds a copy nobody can verify.**

`make check` compares today's simulation against `reference_scorecard`, so it follows whichever
fidelity that line names. Promoting post-layout to the reference is a deliberate act: change the
line, re-certify, and say so in this README's table.

## The two frozen deck sets

| directory | what it is |
|---|---|
| `signoff/prelayout/decks/` | **this design's own** 13 certified benches — the design of record, pre-layout fidelity (was `decks/candidate/`) |
| `decks/reference/` | the analog-db **yardstick** `ldo_005_buffered_ref` — the prior art this design is measured against. Frozen and reproduced by `make check`, and not a result of ours; it is itself outside the box on four specs |

The design of record moved here under template 2.02; the yardstick deliberately did not, because
`signoff/` is for this design's results. The move carried the scorecard's `provenance.raw` pointer
with it — the sha is of the file's *contents*, which did not change, so every hash still
re-derives and `scorecard-recompute` is clean.

**Do not read `reference_scorecard` as naming the design of record.** It still points at
`decks/reference`, so **`make check` proves the yardstick reproduces, not this design's own
scorecard.** That is a real gap: nothing drift-checks the design of record. Decide it before the
next certification.

## One known local lint failure, and why it is not a defect

In a checkout that ran the certification, `make lint` reports:

```
[scorecard-recompute] ledger row 2026-09-07T23:02:35 'candidate_certify':
    raw decks/candidate/decks.sha256 is missing
```

**That row is correct and must not be edited.** It records where the file was when that run
happened; *"never hand-edit the ledger — an edited row is not evidence of a run"*. The scorecard's
own pointer moved with the directory and re-derives cleanly; only this historical row still names
the old path.

- `runs/` is git-ignored and per checkout, so **a fresh clone never sees this.**
- It clears at the next certification, which logs a row at the new path.
