MacAnalog/dn-005-pmu-ldo-capless-ihp130/layout/ldo_ihp_capless/iterations/diff_it01_it02.png

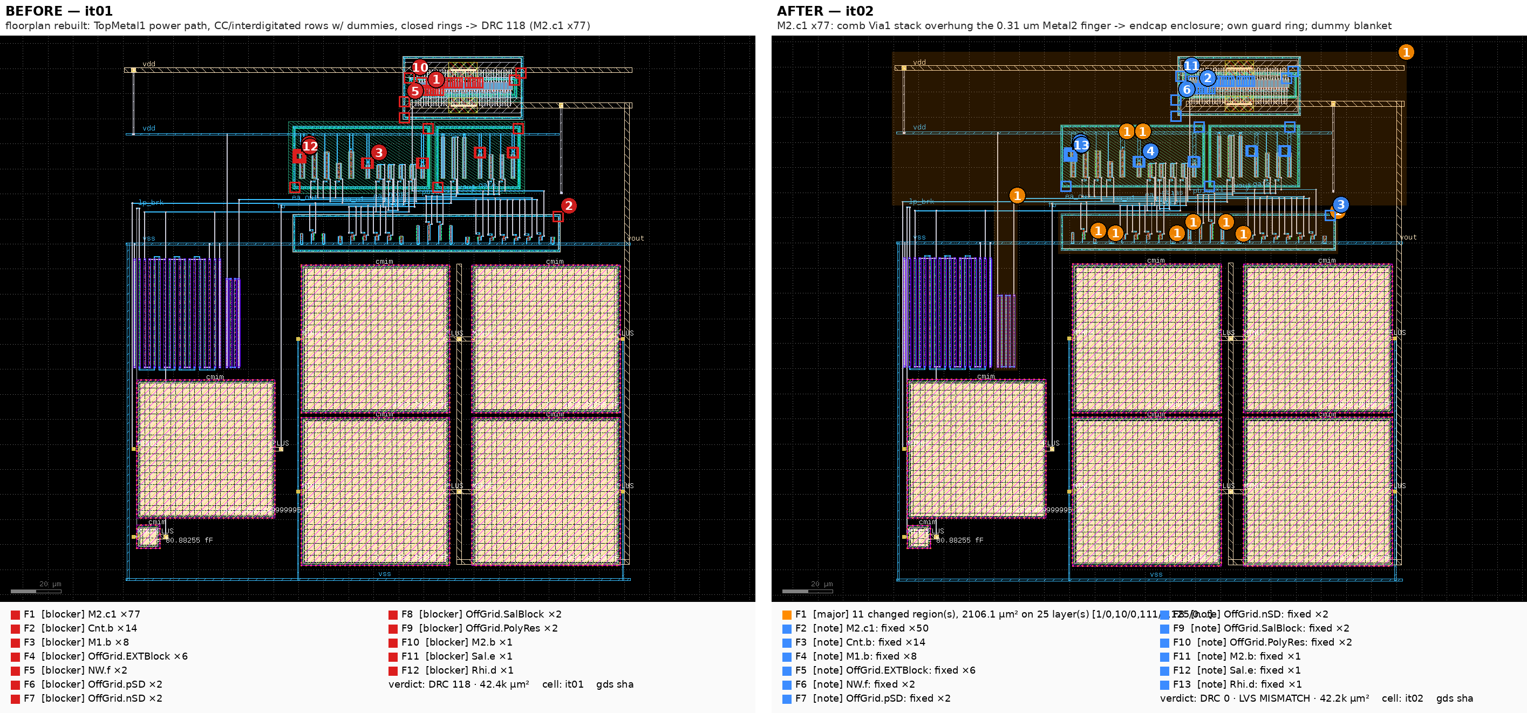
layout/ldo_ihp_capless/iterations/diff_it01_it02.png
