MacAnalog/dn-005-pmu-ldo-capless-ihp130/layout/ldo_ihp_capless/iterations/diff_it02_it03.png

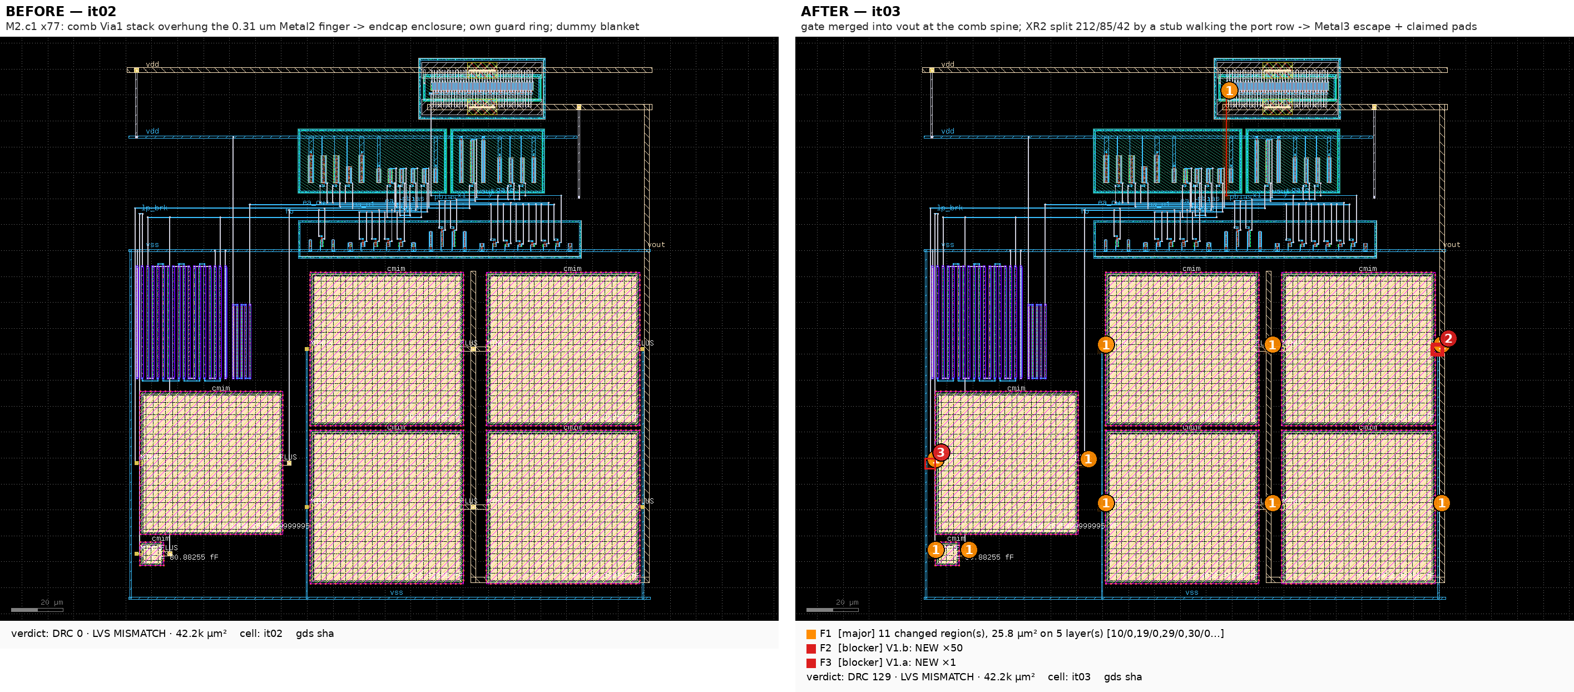
layout/ldo_ihp_capless/iterations/diff_it02_it03.png
