MacAnalog/dn-005-pmu-ldo-capless-ihp130/layout/ldo_ihp_capless/iterations/diff_it07_it08.png

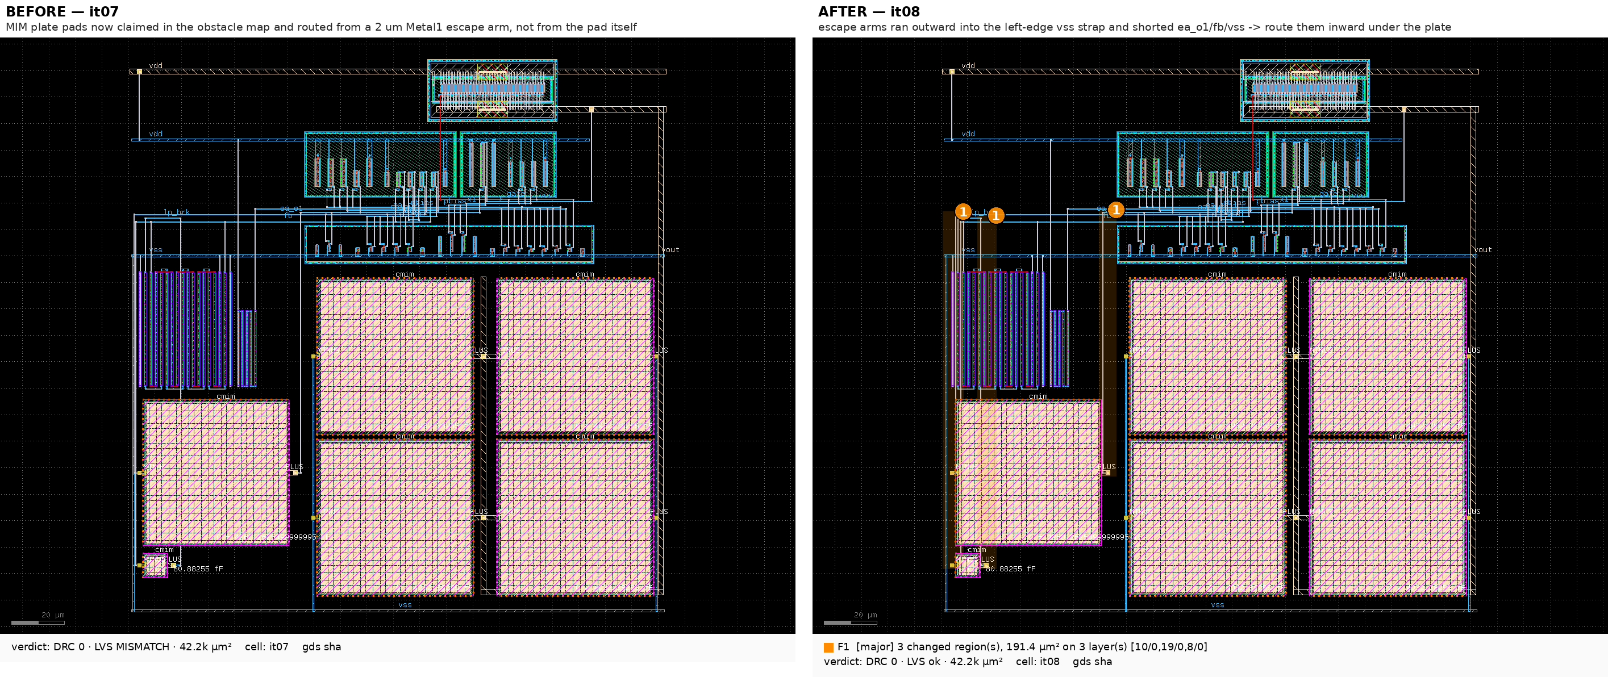
layout/ldo_ihp_capless/iterations/diff_it07_it08.png
