MacAnalog/dn-005-pmu-ldo-capless-ihp130/layout/ldo_ihp_capless/iterations/it01/layout.png

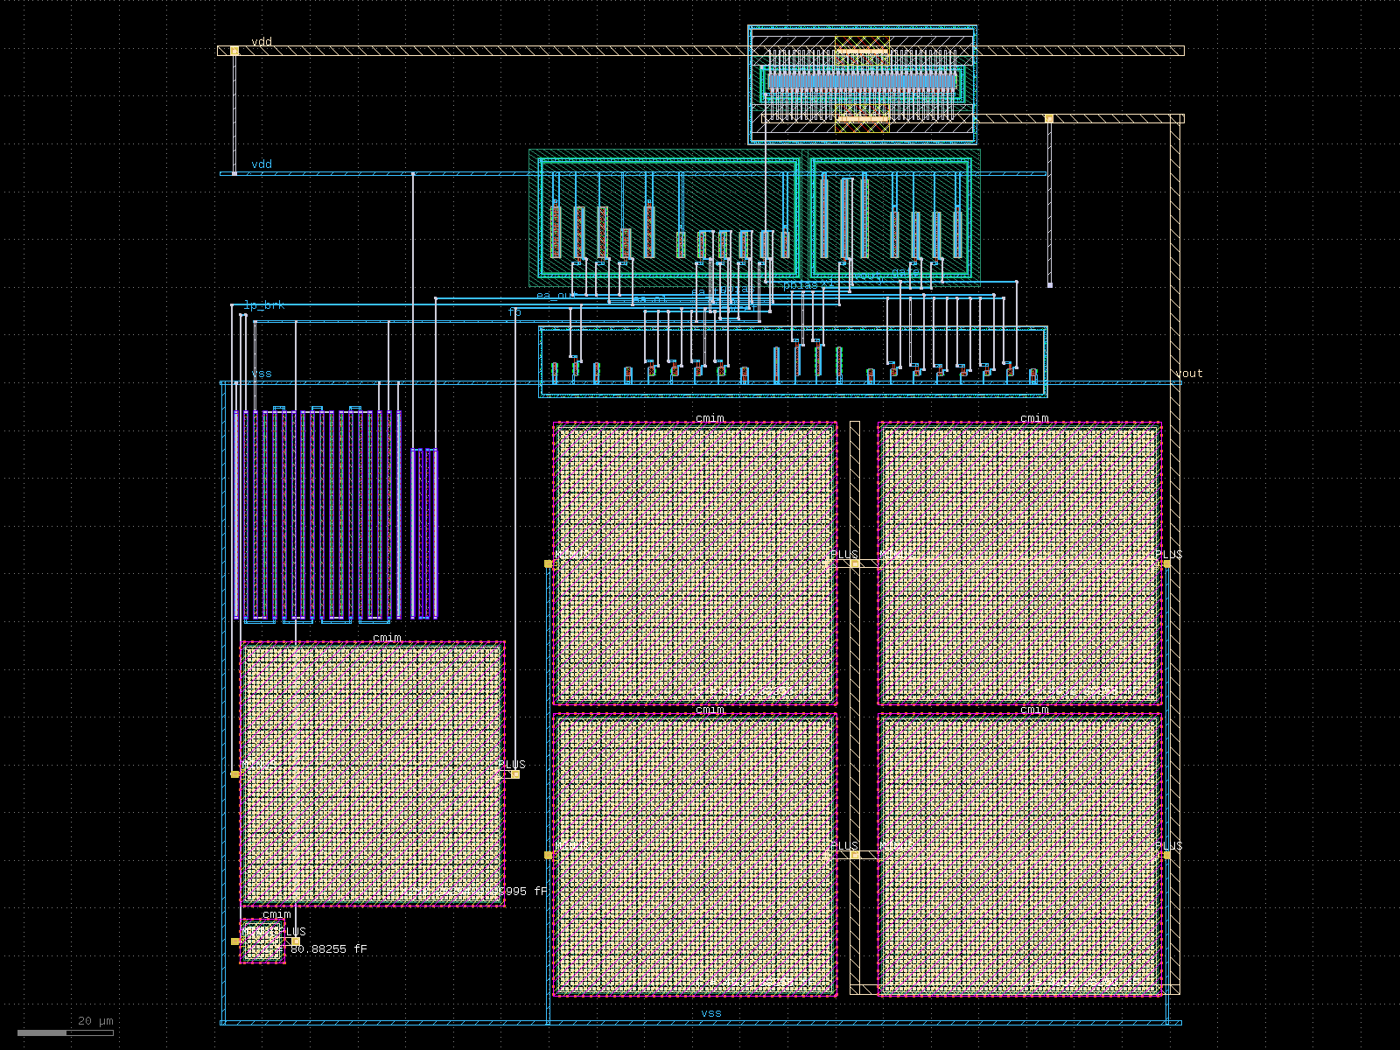
layout/ldo_ihp_capless/iterations/it01/layout.png
