MacAnalog/dn-005-pmu-ldo-capless-ihp130/layout/ldo_ihp_capless/review_crops/F4.png

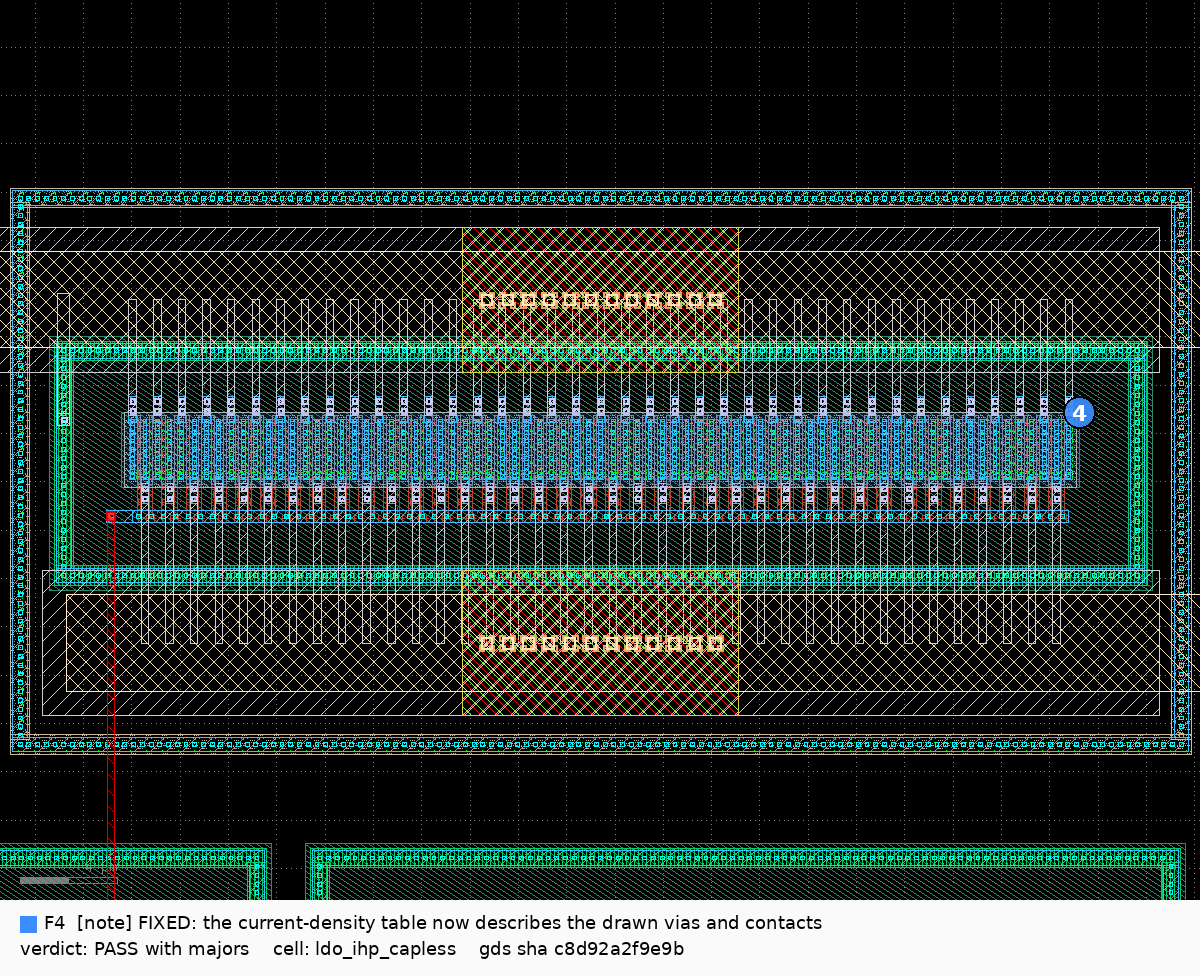
layout/ldo_ihp_capless/review_crops/F4.png
