MacAnalog/dn-005-pmu-ldo-capless-ihp130/layout/ldo_ihp_capless/review_crops/F13.png

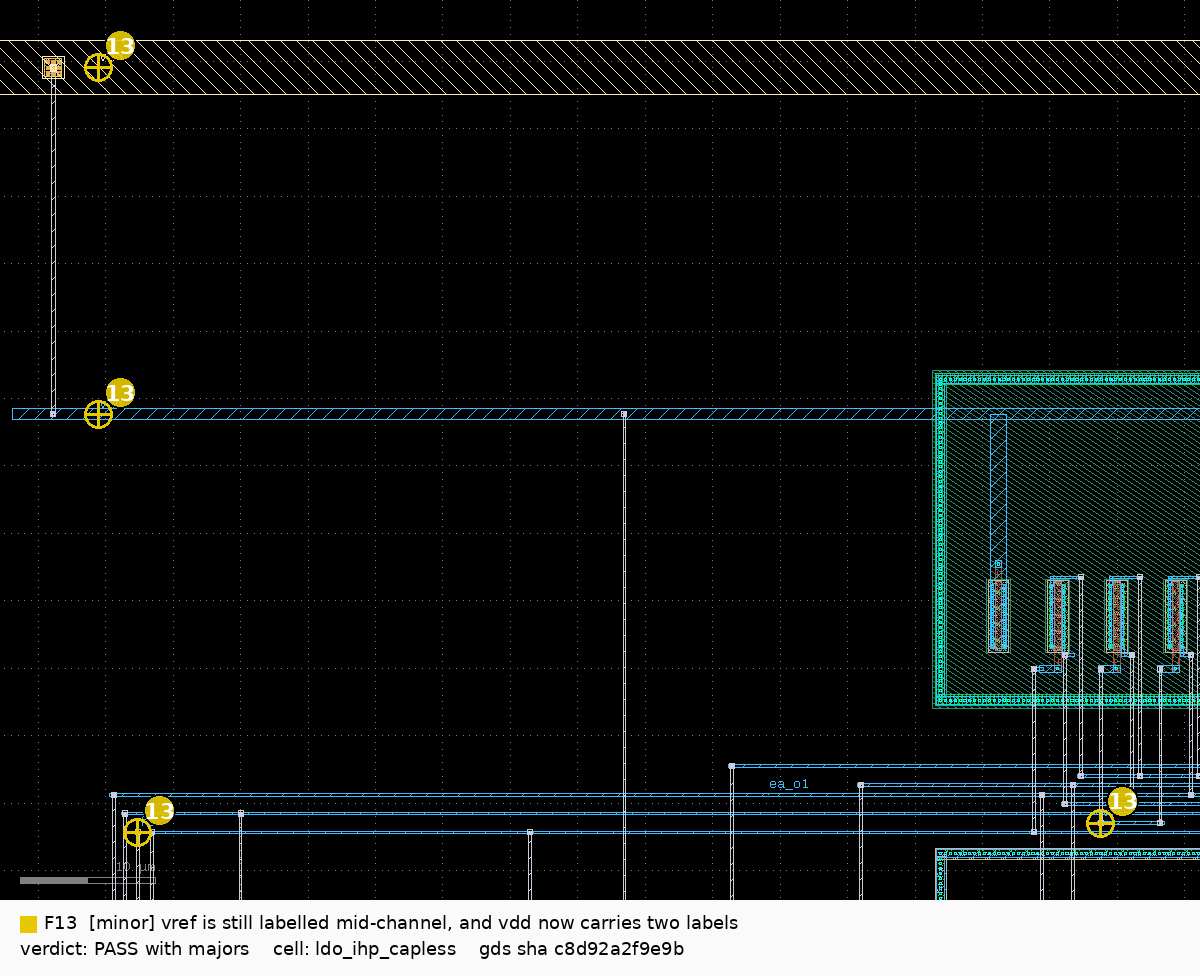
layout/ldo_ihp_capless/review_crops/F13.png
