MacAnalog/dn-005-pmu-ldo-capless-ihp130/experiments/003-sizing/figs/corners.png

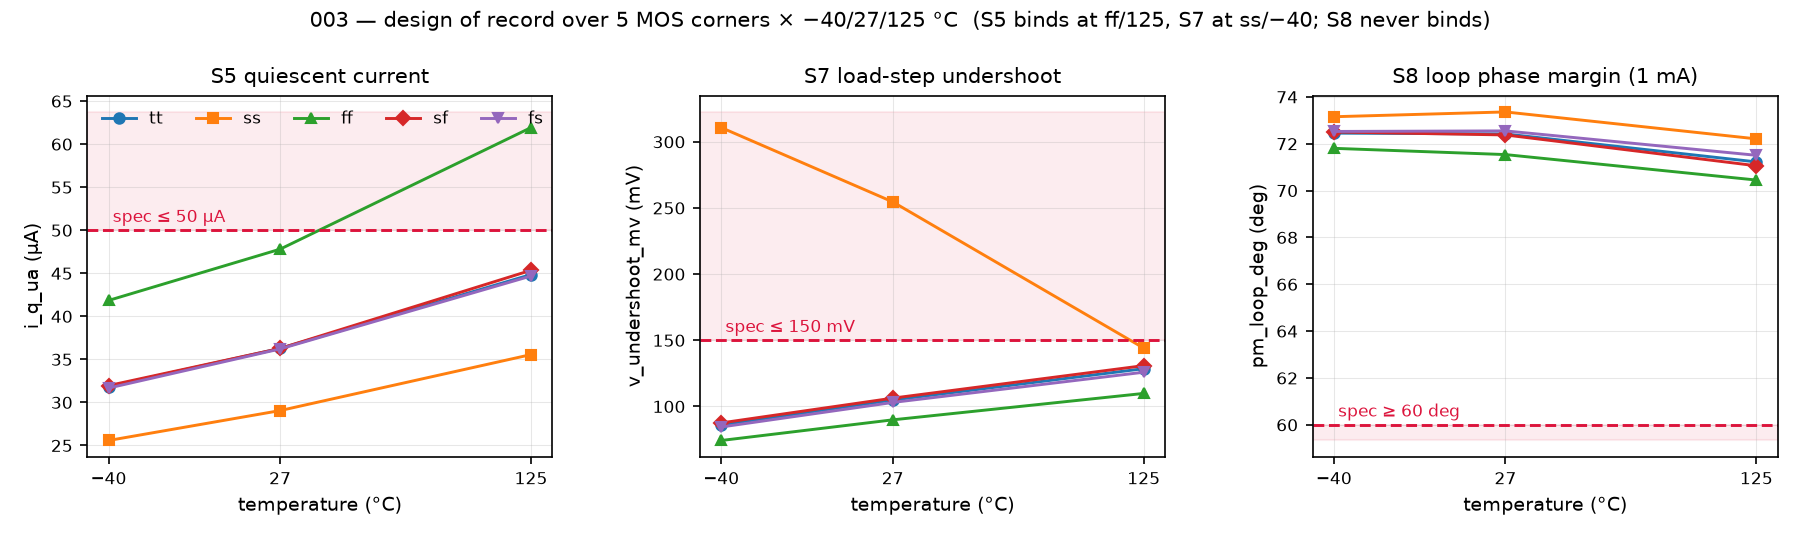
experiments/003-sizing/figs/corners.png
