MacAnalog/dn-005-pmu-ldo-capless-ihp130/experiments/005-layout/figs/ldo_ihp_capless_labelled.png

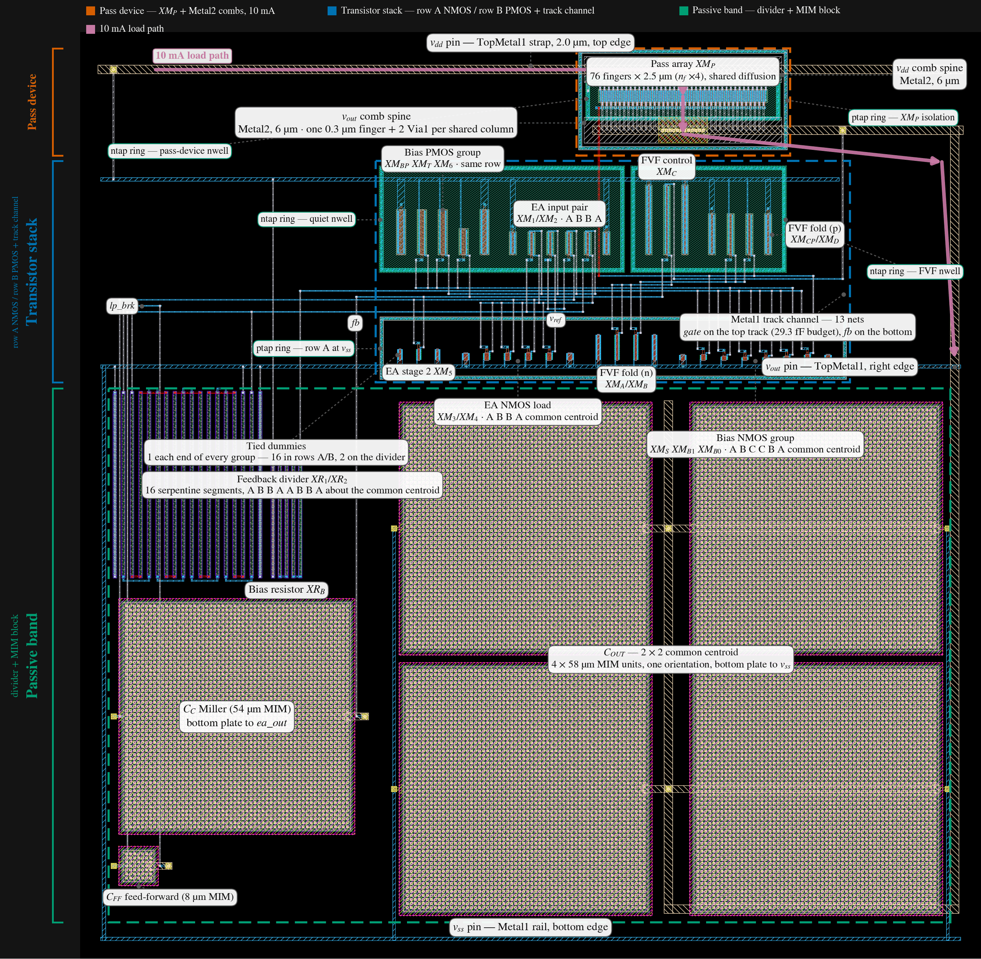
experiments/005-layout/figs/ldo_ihp_capless_labelled.png
