MacAnalog/dn-005-pmu-ldo-capless-ihp130/doc/journal.md

# Journal — index

KIND: REFERENCE (index; `make lint` keeps it complete, newest first)

| date | entry | type | status | hook |
|---|---|---|---|---|
| 2026-09-05 | [a-capacitance-only-extraction-hides-the-strap.md](journal/a-capacitance-only-extraction-hides-the-strap.md) | semantic | live | the pooled `vdd`/`vout` dropout budget was met on a two-strap hand model (10.98 mV) and missed on the stitched RC mesh (29.99 mV, 1.26x) — 85% of the 3.00 Ω is the shared TopMetal1 strap + Via2-TopVia1 stack, which do not divide by the 39-column parallelism the hand model assumed |
| 2026-09-05 | [a-display-shortening-reached-the-netlist.md](journal/a-display-shortening-reached-the-netlist.md) | procedural | live | a schematic emitter abbreviated any value over 24 characters into the attribute it NETLISTS, so two bench sheets ran a truncated `pulse(...)` while every topology check passed — shorten for the drawing, never for the stored value, and compare values not just connectivity |
| 2026-09-05 | [a-readable-hierarchy-must-flatten-back.md](journal/a-readable-hierarchy-must-flatten-back.md) | procedural | live | redrawing the cell as five blocks changes what xschem netlists back; splice the blocks inline PRESERVING leaf names, keep both drawings on both gates, and grep the decks for hierarchical paths (`@v.xdut.vlp`) before choosing block boundaries |
| 2026-09-05 | [a-green-gate-on-a-collapsed-drawing.md](journal/a-green-gate-on-a-collapsed-drawing.md) | procedural | live | a mid-task recertification renamed every segmented device, three of five blocks silently emptied, and BOTH gates stayed green on the collapsed drawing — assert the STRUCTURE (device coverage, block count) beside the meaning |
| 2026-09-05 | [an-isomorphism-carries-no-sizes.md](journal/an-isomorphism-carries-no-sizes.md) | procedural | live | compare_netlists matched 25 components and 15 nets while the drawing carried no cap sizes and a 3 V reference — after topology, compare every parameter by number and never default w/l |
| 2026-09-04 | [a-floorplan-is-bought-not-found.md](journal/a-floorplan-is-bought-not-found.md) | semantic | live | closing the current-density and matching findings cost +19.6 % area and pushed `gate`/`fb` over their pre-drawing budgets — a parasitic budget is a ranking with a scale, not a gate; the physical limit is the gate |
| 2026-09-04 | [one-guarded-frozen-dir-guards-one-frozen-dir.md](journal/one-guarded-frozen-dir-guards-one-frozen-dir.md) | procedural | live | deleting an "unused" `VOUT_THRESH` left every candidate deck unbuildable and `deck_rebuild` guarded only decks/reference, so nothing caught it — a placeholder in a template comment still binds, and a lint runs over the whole `frozen:` set |
| 2026-09-04 | [vacuous-equivalence-passes.md](journal/vacuous-equivalence-passes.md) | procedural | live | compare_netlists returned equivalent=True having matched 0 then 1 components; report components_matched beside every verdict and compare the cell flat |
| 2026-09-04 | [netlist2xschem-skips-3-terminal-resistors.md](journal/netlist2xschem-skips-3-terminal-resistors.md) | procedural | superseded | IHP rhigh/rppd/rsil are 3-terminal subckts, the res symbol has 2 pins: they vanish from the drawing and the run still exits 0 — diff the device count |
| 2026-09-04 | [singular-matrix-is-a-warning.md](journal/singular-matrix-is-a-warning.md) | procedural | live | ngspice prints `Warning: singular matrix` while gmin-stepping and then converges; lab.sim's own fatal table threw away 7 of 13 post-layout benches whose measures were in the log — FIXED, it now calls the platform's severity-ordered `sim_log.fatal_lines` |
| 2026-09-04 | [kpex-cards-are-not-ngspice-cards.md](journal/kpex-cards-are-not-ngspice-cards.md) | procedural | live | a PEX netlist is an LVS report: primitive cards for subckt devices, `$` net names, a VSUBS node that is not a pin — plus run_lvs.py needs docopt |
| 2026-09-04 | [metal1-stub-shorts-are-drc-invisible.md](journal/metal1-stub-shorts-are-drc-invisible.md) | semantic | live | overlapping Metal1 merges into one legal polygon, so a 50 nm knob change shorted fb to vref with DRC at 0 violations; a routing generator needs a per-net obstacle map |
| 2026-09-04 | [resistor-bias-spread-binds-both-ends.md](journal/resistor-bias-spread-binds-both-ends.md) | semantic | live | a resistor-referenced bias spread Iq 2.4x over corners: S5 fails at ff/125 and S7 at ss/-40, pulling the same knob opposite ways — bias architecture, not sizing |
| 2026-09-04 | [round-then-rescore.md](journal/round-then-rescore.md) | procedural | live | rounding the optimizer's floats to the layout grid is a design change; a 50 nm grid moved the pass device off the PDK minimum length and cost 140 mV of undershoot |
| 2026-09-04 | [optimizer-parks-on-cliffs.md](journal/optimizer-parks-on-cliffs.md) | semantic | live | the winner sat 15 nm from a c_ff_w cliff that took S7 from 107 to 201 mV while every metric the optimizer scored stayed smooth; ship the point plus its local sweep |
| 2026-09-04 | [plain-fvf-gate-ceiling.md](journal/plain-fvf-gate-ceiling.md) | semantic | live | a plain FVF caps the pass gate at vout, so the pass device leaks 80–470 µA at ff/hot and regulation is lost; a PMOS SF/SSF buffer rings, the double-mirror fold fixes it |
| 2026-09-04 | [fvf-gate-cap-is-slew.md](journal/fvf-gate-cap-is-slew.md) | semantic | live | 5 pF at the FVF pass gate turned a 65 mV load step into 553 mV: the sink slews it alone; damp with L, not C |
| 2026-09-04 | [analog-db-has-no-overlay-root.md](journal/analog-db-has-no-overlay-root.md) | procedural | live | load_circuit reads only its own root and assemble() has no temp arg; lab.dut resolves circuits/<id>/ locally and rewrites the one generated .temp line |
| 2026-09-04 | [lab-venv-lacks-the-physical-lanes.md](journal/lab-venv-lacks-the-physical-lanes.md) | procedural | live | gmid/layout/signoff were not in the template venv; added as path sources, gdsfactory stays in a second interpreter |
| 2026-09-04 | [template-gaps-t8.md](journal/template-gaps-t8.md) | procedural | live | nine template gaps from the T8 instantiation (uv transitive sources, spec tokens, vendor names in class-template comments, wrapper title line, batch() signature, log row name…) + the generic lab code to promote |
| 2026-09-04 | [reference-is-not-at-the-target-point.md](journal/reference-is-not-at-the-target-point.md) | semantic | live | ldo_005 is hv/3.3 V/1.6 V/1 µF; only S2/S3/S5/S6/S8 are quotable, S4/S7 come from the literature until a re-based reference (exp 002) |
| 2026-09-04 | [metal-current-density-is-nobodys-check.md](journal/metal-current-density-is-nobodys-check.md) | semantic | live | the 10 mA path is 12–28× over the Metal1/Via1 limit and DRC, LVS and PEX are all blind to it; widening in place fails (117 → 79 violations), the fix needs upper metal + floorplan room |
| 2026-09-04 | [run-lvs-swallows-its-own-traceback.md](journal/run-lvs-swallows-its-own-traceback.md) | procedural | live | run_lvs reports matched=False with an empty reason while the ModuleNotFoundError sits in the returned log; read the raw log before naming a cause, and fix the reporting not the environment |
| 2026-09-04 | [prefix-precedence-drops-drawable-devices.md](journal/prefix-precedence-drops-drawable-devices.md) | semantic | resolved upstream | "netlist2xschem cannot draw a 3-terminal rhigh" was wrong — the PDK ships a 2-pin rhigh.sym; it is a prefix-precedence bug in ingest.py:149–162 (supersedes netlist2xschem-skips-3-terminal-resistors.md) |
| 2026-09-04 | [a-signed-row-that-can-never-match.md](journal/a-signed-row-that-can-never-match.md) | semantic | superseded | make lint's scorecard-recompute cannot be greened by ANY signed row: certify() writes the tag under provenance, _backing_rows matches a top-level tag; demonstrate a gate can go green before calling it "waiting on a signature" |
| 2026-09-01 | [gap-as-signal.md](journal/gap-as-signal.md) | seed | live | a trap that bites twice becomes a lint |
