MacAnalog/dn-005-pmu-ldo-capless-ihp130/(commit log)

2026-09-04 scaffold: instantiate agentic-design-template as ldo-ihp130
    - capless, low-Iq LDO in IHP SG13G2 (lv 1.5 V devices, Vin 1.5 V, Vout 1.2 V, Cout on chip)
    - harness.yaml: name/env vars (LDO_EXP, LDO_JOBS), provisional 8-row acceptance box with
    unit-scaled keys, EDA-vendor/foundry denylist, ledger columns
    - doc/: mission map (CLAUDE.md), target-spec (provisional bounds), benches (analog-db LDO class
    templates as the definitions + key map), design-reference (constraints), environment (PDK pin)
    - pyproject: editable path deps on the platform (harness, core, spicexplorer, analog-db + members)
    - lab/ still the template stubs; filled in on feat/001-reference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
2026-09-06 001-reference: lab on the platform stack, ldo_005 certified as the IHP reference, target spec of record (#1)
    ## What was done
    - `lab/` on the platform stack: `sim.py` (deck text → `NGSpice_Wrapper`, per-run dirs under `$SX_SCRATCH`, fatal-string scan, `preflight()`), `dut.py` (`Design` = analog-db circuit binding + `.param` overrides, byte-reproducible `deck()`), `metrics.py` (analog-db LDO class benches → unit-scaled spec keys, every evaluate appends a ledger row; `--certify/--check`).
    - Reference certified: analog-db `ldo_005_buffered_ref` in IHP SG13G2 tt at its committed conditions (3.3 V hv devices, 1.6 V out, 1 µF Cout); 10 benches, all 16 numbers equal the analog-db baseline to t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
    [ac_loopgain_hi_tb.sch, ac_loopgain_lo_tb.sch, ac_loopgain_tb.sch, bias_ref.sch, dc_op_tb.sch, dropout_tb.sch, ea_stage1.sch, ea_stage2.sch]
2026-09-07 harness: a schematic request means the xschem sheet of record (#2)
    **What was done**
    - `schematic-of-record` method: new "What counts as a schematic" section — a schematic request means the generated, gated xschem `.sch`/`.sym` with its committed render; a hand-drawn SVG, block diagram or sketch is not a schematic. The one exception is a cell already ported through the bridge's `xvport` lane, shown from its ported cellview (kept identical to the `.sch` by the circuitgraph check).
    - `CLAUDE.md` pointer to the rule where the repo already routes "see the circuit" (template + transmitter).
    **Assumptions**
    - Owner ruling 2026-09-07, written verbatim into the harness; vendor names stay out per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
2026-09-07 CLAUDE.md: simulation lanes by PDK + SpiceXplorer-first reuse (#3)
    * CLAUDE.md: simulation lanes by PDK (open → native; NDA → bridge only) + SpiceXplorer-first reuse, the contract for every agent
    Claude-Session: https://claude.ai/code/session_01EHXzwwUcUa6bAwFwpfimK4
    * CLAUDE.md: the schematic + report flow (xschem sheets for every cell and testbench via netlist2xschem, xvport for the commercial editor, findings as regenerated plots, experiments/NNN-* report shape)
    Claude-Session: https://claude.ai/code/session_01EHXzwwUcUa6bAwFwpfimK4
    ---------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
2026-09-07 CLAUDE.md: a declined /CMC prompt is never a stop — continue without the kit bytes (#4)
    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
2026-09-08 feat(sign): the verifier's tool — re-measure a frozen dir and sign it only if it reproduces bit for bit (#6)
    What was done
    - ldo/sign.py (new): `python -m ldo.sign DIR --author <designer> --verified-by <verifier>` simulates the dir's frozen *.spice bytes, re-derives the provenance block (`ledger.provenance`) and diffs it against the committed one (`verify.provenance_diff`); only an empty diff — same scorer sha, same deck digest, same 33/49 numbers — logs `evidence="signed"` with the committed hash block. Otherwise it prints the column report and exits 1.
    - Makefile `make sign DIR=… AUTHOR=… VERIFIED_BY=…`; CLAUDE.md lists it next to `make freeze`.
    - Live: signed decks/candidate (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
2026-09-09 skills: the shared agents/skills are links into the .sx/skills library (addfb44), no longer copies; make init + make skills-update (#7)
    The copied .claude/agents and .claude/skills (2026-09-04 snapshots) had drifted from the library — schematic-of-record, layout-evidence and findings-as-plots differed. Same scheme as the template and zb-001/dv-001. Gates on this checkout: lint green, doctor ok, check green.
    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
2026-09-09 skills: bump .sx/skills to a88b9a2 (spicexplorer-tools skill: interpreter rule for every platform tool; member-safe schematic command; link sets) (#8)
    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
2026-09-09 skills pin → 695a769 (library #12 sx-contributing + #9 gmid-lut-generation); sx-contributing linked (#9)
    - **.sx/skills a88b9a2 → 695a769** via `make skills-update`; `.claude/skills/sx-contributing` link added (the design link set carries it): the contribute-back rule — quick fix → PR now; bigger, and every new/changed agent or skill definition → a descriptive issue on the owning repo; `# GAP:` marker; propose the reusable skill/agent proactively.
    - Also brings library #9 (gmid-lut-generation: union the design's lengths; the L gap ratio sets the interpolation error).
    ## Next Steps
    - none — pin bump only; `make check` unaffected (links resolve, `sx-link --check`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
2026-09-09 skills pin → 71cd4dd (library #14: sx-contributing — labels on the first body line for read-only members) (#10)
    - **.sx/skills 695a769 → 71cd4dd** via `make skills-update` (links unchanged). `make lint` in dn-004 at 695a769: all invariants hold; linked library text is denylist-exempt.
    - none.
    https://claude.ai/code/session_01EHXzwwUcUa6bAwFwpfimK4
    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
2026-09-09 skills pin → d5fa4c9 (sx-contributing: members hold triage — --label applies) (#11)
    - **.sx/skills 71cd4dd → d5fa4c9** via `make skills-update` (links unchanged).
    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
2026-09-09 skills pin → 983792e (sx-contributing: public repos carry nothing about the secret work) (#12)
    - **.sx/skills d5fa4c9 → 983792e** via `make skills-update` (links unchanged).
    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
2026-09-10 skills pin → 21fe887 (spectre-lane: the kit path never enters a deck — $VAR resolved at run time) (#13)
    - **.sx/skills 983792e → 21fe887** via `make skills-update` (links unchanged): the lane skill now carries the deck-portability pattern and its worked-example paths use the current repo names.
    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
2026-09-10 template versioning: record 1.00 and carry `make template-status` / `template-update` (#14)
    - **`.sx/template-version` = `1.00`**: this design now records the template release it stands on. 1.00 is the first tagged release (the template as it stood on 2026-09-09); this design was cut before it, so the record is a floor, not a claim — the first propagation may raise conflicts a human resolves, never a silent overwrite.
    - **`scripts/template_update.py` + `make template-status` / `make template-update`**: `status` compares the recorded release with the templates newest tag and prints the changelog between them; `update` fetches the template as a remote and applies the diff fi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
2026-09-10 signoff: move the design of record into signoff/prelayout/decks (template 2.02) (#18)
    - **`decks/candidate/` -> `signoff/prelayout/decks/`** — this design's 13 certified benches now
    live in the sign-off tree instead of being indexed from it. `.sx/template-version` -> 2.02.
    - The scorecard's `provenance.raw` pointer moved with them
    (`decks/candidate/decks.sha256` -> `signoff/prelayout/decks/decks.sha256`) and `SHA256SUMS` was
    regenerated by `make freeze`. **No number, no rawfile and no scorer changed** — the sha beside
    each path is of the file's contents, so every hash still re-derives.
    - **`decks/reference/` deliberately stayed put**: it is the analog-db yardsti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
2026-09-10 template 2.03: take the relocation fixes and the ledger note (#19)
    - `.sx/template-version` 2.00 -> 2.03 via `make template-update`: the multi-line `frozen:` read,
    `artifact_home`'s local `subprocess` import, the clean refusal for a missing
    `scripts/template_update.py`, the relocating `move_reference`, and the ledger note.
    ## Errors / setbacks / gotchas
    - The template's `EXTRA = (...)` constant merges into any design that registers its checks INLINE
    instead, naming checks that design does not define — a `NameError` at import, i.e. a lint that
    cannot run rather than one that fails. It is dropped here with a comment saying why, so the next
    release does not re-la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
2026-09-10 template 2.04: create the sign-off tree's figs/ and tables/ so git keeps them (#20)
    - `.sx/template-version` -> 2.04, and every `signoff/<fidelity>/{figs,tables}/` now exists with a
    `.gitkeep`.
    - The earlier migration created these with a bare `mkdir`. git does not track an empty directory,
    so they were silently dropped at commit and this repo had a `signoff/` tree that its own
    `README.md` described and did not have. Fixed in the template so no later design repeats it.
    - None; these are the homes an experiment's evidence is promoted into at sign-off.
    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
2026-09-11 Codex review: the README says which sizing its numbers came from (#21)
    * doc: the README's corner headline was the superseded 36.28 uA sizing
    - README "Where the design stands": the single `worst corner` row quoted 003
    (61.9 uA @ ff/125, 310.8 mV @ ss/-40, 12/15 PASS), which is the sizing point
    the F19 re-certification replaced. Replaced with the two rows 007 measured at
    the 33.81 uA cell: schematic 58.37 uA @ ff/125, 301.8 mV @ sf/-40, 8/15 PASS;
    post-layout CC 58.37 uA @ ff/125, 171.1 mV @ ss/125, 10/15 PASS. Both are
    per-column worsts over the 15-cell grid, and both are CC — the RC corner grid
    was never run, so no CC->RC dropout addition is quoted as a measurement.
    - The 00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
2026-09-11 chore: bump .sx/skills to 2ab0895 (Stage B: commercial-kit port + measurement setup of record) (#22)
    - `make skills-update`: .sx/skills 21fe887 -> 2ab0895, re-linked (9 agents + 17 skills).
    - Picks up analog-skill-directory#26, which closes #23/#25: the schematic of record
    continues into the editor, and the measurement setup has an owner.
    ## Assumptions
    - Pin-only. The template version is deliberately NOT moved in this PR.
    ## Errors, setbacks, gotchas
    - Template 2.05 was attempted and withdrawn here: its metrics.py rewrite conflicts with this
    design's own certify/freeze path and references a package-level `bench_mod.reduce` this
    design does not define. Taking it woul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
2026-09-21 skills: bump .sx/skills to 581c33b
    - Moved the `.sx/skills` submodule pin (the shared agent/skill library, MacAnalog/analog-skill-directory) from `2ab0895` to `581c33b`, and re-linked `.claude/` against it.
    - Done with `make skills-update`. No design content touched.
    - Why now (owner decision 2026-09-21): the library's `analog-learning-journal/scripts/extract_models.py` was scrubbed — it no longer carries a literal kit-tree path; the fallback include now comes from the lane's `<PDK-ID>_PDK_LIB` env var. This pin is what brings that scrubbed script to the design.
    - The library's `hooks/` were re-synced to the canonical workspace guards in the same range (the guard mirrors'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
2026-09-26 skills: bump .sx/skills to e9c0230 (library close-out, MacAnalog/analog-skill-directory#79) (#24)
    - **Pin:** `.sx/skills` (MacAnalog/analog-skill-directory) moves `581c33b` → `e9c0230`, the library's `main` after MacAnalog/analog-skill-directory#79. The range is 3 commits: MacAnalog/analog-skill-directory#77, MacAnalog/analog-skill-directory#78 and MacAnalog/analog-skill-directory#79.
    - **How:** `make skills-update`, then a check that `.sx/skills` HEAD equals `e9c023002da0fc4f82777b9e6e86b8d5eb457113`.
    - **Diff:** the `.sx/skills` gitlink and one new symlink, `.claude/skills/spectre-lane`. No design file changes.
    - **Linked set:** 10 agents + 18 skills → 10 agents + 19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
2026-09-26 Close-out wave 2 sync: relock against platform 1b08a0a, skills pin 799499e, ten agents in CLAUDE.md (#25)
    - `uv.lock` relocked against the shared platform at `1b08a0a` (+37/−5): `sympy` and `mpmath` added (a base dependency of `spicexplorer` now); `control` not added (the platform dropped it, MacAnalog/spicexplorer-platform#304); new edges from `spicexplorer-core`, `-layout` and `-signoff` to packages already in the lock.
    - `.sx/skills` pin `e9c0230` → `799499e` (library close-out wave 2, MacAnalog/analog-skill-directory#82 and MacAnalog/analog-skill-directory#86); the agent and skill links did not change.
    - `CLAUDE.md`: ten agents are linked, not nine; the table gains t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
2026-10-05 Close-out round 3 sync: pdk, the v2.14 memory block, skills 0c2bf08 (#26)
    Close-out round 3 sync: declare the PDK, take the template v2.14 memory block, bump the skills pin to 0c2bf08, and mark the template's seed entry. The template itself stays at 2.04 (see Errors).
    - `harness.yaml`:
    - `pdk: ihp-sg13g2`, the id `ldo/config.py` `PDK` holds (`make doctor`).
    - The template v2.14 `memory:` block. `index_size_cap: 32000` is dropped: `index_live_bytes` is 7426 on main and 7420 with the seed mark, under 20000.
    - `doc/memory/archive/README.md` from template v2.14 (MacAnalog/agentic_design_template#46).
    - `.sx/skills` 799499e → 0c2bf08 (MacAnalog/analog-skill-directory#89).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
2026-10-08 skills: bump .sx/skills to 4645ffa; relock without sympy (#27)
    - `.sx/skills` 0c2bf08 -> 4645ffa via `make skills-update`: links the four use-case agents (design-tutor, troubleshooter, design-customizer, results-analyst) and the `hand-analysis` and `sx-use-cases` skills; `hand-analysis` uses netlist2tf's `operating_point_from`.
    - uv.lock relocked against the shared platform 2c8507f: sympy and mpmath leave (platform #307 made sympy optional).
    - `make lint` reports the pre-existing scorecard-recompute and dropout-threshold findings (the open dn-005 re-certification item); nothing here changes them.
    - Try the use-case agents on thi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
